ROAR-QUTRC/perseus-v2/README.md

# perseus-v2

The main codebase for perseus starting 2024

## Documentation

Full documentation is located [here](https://roar-qutrc.github.io/)

## CI/CD Status
