ROAR-QUTRC/perseus-v2/software/web_ui/README.md

# Rover UI

This repo contains the UI for controlling/viewing outputs from sensors on the rover.

### Running the UI

The Rover UI uses SvelteKit meaning that it does not need a server to be run and can be started by running this command in the root directory:

```shell
yarn # This installs dependencies
yarn host # This runs the server
```

This command with host the UI so with Vite so that it can be accessed by any device on the same network.  
**Note:** The hydration errors can be ignored

### Developing

To begin developing a widget run the command: `./create-widget.sh <file-name>`. The `file-name` argument is just the name of the file that contains the widget and **NOT** the widget name. This should generate a new file `/src/lib/widgets<file-name>.svelte` with this template contents:

```svelte
<script lang="ts" module>
	import type { WidgetSettingsType } from '$lib/scripts/state.svelte';

	export const name = 'New Widget';

	export const settings: WidgetSettingsType = $state<WidgetSettingsType>({
		groups: {}
	});
</script>

<script lang="ts">
	// Widget logic goes here
</script>

<p>New component</p>
```

- The first script tag with the `module` property is a server only module. This is used here as it is only run once when the component is first loaded and it also allows for exports that are used to expose some properties. You likely will not need to write your own code here.
  - **name -** This string is the unique name of the widget that will be displayed at the top of the widget and is used to ensure duplicates of widgets are not loaded.
  - **settings -** This is the object that structures the settings/state panel of each widget. Here is an example settings object and how to access the value of each setting:

    ```ts
    export const settings: WidgetSettingsType = $state<WidgetSettingsType>({
      groups: {
        general: {
          textSetting: {
            type: "text", // options are: text, number, switch, select, button
            value: "Some text", // This is a default value
          },
          hereIsAButton: {
            type: "button",
            action: () => {
              // action is executed on button press
              console.log("Button clicked");
              return "Success"; // string return value is printed in a toast
            },
          },
        },
        Advanced: {
          booleanSwitch: {
            type: "switch",
            description: "This is a switch", // fields with descriptions get a question mark next to their label
          },
          selectOptions: {
            type: "select",
            options: [
              { value: "1", label: "Option 1" },
              { value: "2", label: "Option 2" },
              { value: "3", label: "Option 3" },
            ],
          },
        },
      },
    });

    console.log(settings.groups.Advanced.booleanSwitch.value); // logs the state of the switch
    ```

- The second script tag is where your code should go as it is run client side when the component is rendered. The settings can be accessed here without an import and to listen for changes wrap the value you want to check in either a `$derived` or `$effect` rune. Furthermore, use `toast('message')` to send a toast from your widget.
- The remainder of the file is where mark down goes. Tailwind classes can be used on widgets for styling or a `<style></style>` block.

## TODO:

### Widgets

- Camera
- Battery
- Motor stats
- BMS (power bus states)
