ROAR-QUTRC/perseus-v2/software/arm-teleop-direct/README.md

# perseus-arm-teleop

Terminal based Arm Teleop for Perseus

By default this will connect two arms connected via serial ports on the one machine.

It will display torque readings and position.

Calibration values for leader and follower arms can be saved to a .yaml file.

Always make sure all servos are on the same baud rate. 1M baud is able to be handled.

# Build

```
mkdir build
```

```
cmake ..
make
```

# Use

You can run locally by running the application built from the build process.

Alternatively see below on how to use for teleoperation over a local network.

## To use over a network for teleoperation

We need to virtualise a remote serial port and present it as a local device. We can do this using the
Linux tool socat.

To install on Ubuntu

```
sudo apt install socat
```

#### First set up the Follower

This assumes serial port being used for the arm is /dev/ttyACM0.

```
socat TCP-LISTEN:7100,reuseaddr /dev/ttyACM0,b1000000,raw,echo=0
```

#### Second set up the Leader

This sets up a local file which is actually network connected to the remote serial port.
This assumes the remote machine has an IP Address of 192.168.1.15

```
socat PTY,link=/home/dingo/leader_follower,raw,echo=0 TCP:192.168.1.15:7100
```

Then run the application and the virtualised remote port should be detected automatically.

## TODO

- Handle rollover of values (joint #2 really needs this)
- Add PID to movements to reduce jerkiness
- Add ability to include 24 servos (second leader and second follower)
- Add additional diagnostic info

## DONE

- Add yaml config file loading
- Colour code torque values (mostly for gripper)
