ROAR-QUTRC/perseus-v2/docs/source/standards/README.md

# Standards

This section contains information about the standards to which hardware and software on-board the rover should be developed.
