ROAR-QUTRC/perseus-v2/docs/source/hardware-index.md

# Hardware

This sections contains information on the physical pieces of hardware within Perseus.
If you're looking for information on hardware _systems_, like networking, please see <project:/systems/hardware-index.md>.

## Board Name Abbreviations

```{glossary}
SBB
    <project:hardware/smol-brain-board.md>

RCB
    <project:hardware/rover-control-board.md>

CAN Daisy Chain Board
Daisy Chain Board
    <project:hardware/can-daisy-chain.md>

VESC
    The type of ESC used on Perseus. See more here: <project:hardware/vescs.md>
```

```{toctree}
:maxdepth: 1
:titlesonly:
:hidden:
:glob:
hardware/*
```
