ROAR-QUTRC/perseus-v2/docs/source/hardware/rover-control-board.md

# Rover Control Board

This PCB handles most of Perseus' power distribution and monitoring.
