ROAR-QUTRC/perseus-v2/docs/source/systems/hardware-index.md

# Hardware Systems

```{toctree}
hardware/assembly
hardware/i2c_imu
hardware/network
```
