ROAR-QUTRC/perseus-v2/docs/source/standards/hardware.md

# Hardware Design Guidelines

Power cables should be made with XT90 connectors only
