ROAR-QUTRC/perseus-v2/docs/source/standards-index.md

# Standards

This section contains information about the standards to which hardware and software on-board the rover should be developed.

```{toctree}
:maxdepth: 1
:titlesonly:
:hidden:
:glob:
standards/*
```
