ROAR-QUTRC/perseus-v2/software/ros_ws/src/perseus_simulation/models/perseus_arc_world/aruco_markers1/textures/aruco01.png

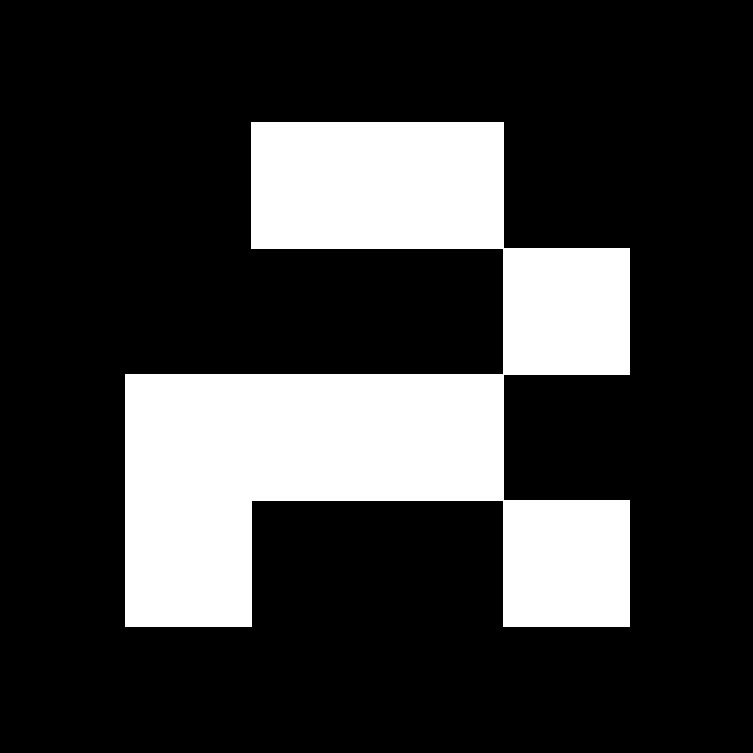
software/ros_ws/src/perseus_simulation/models/perseus_arc_world/aruco_markers1/textures/aruco01.png
