ROAR-QUTRC/perseus-v2/software/ros_ws/src/perseus_simulation/models/Moon_DEM/materials/textures/sand.jpg

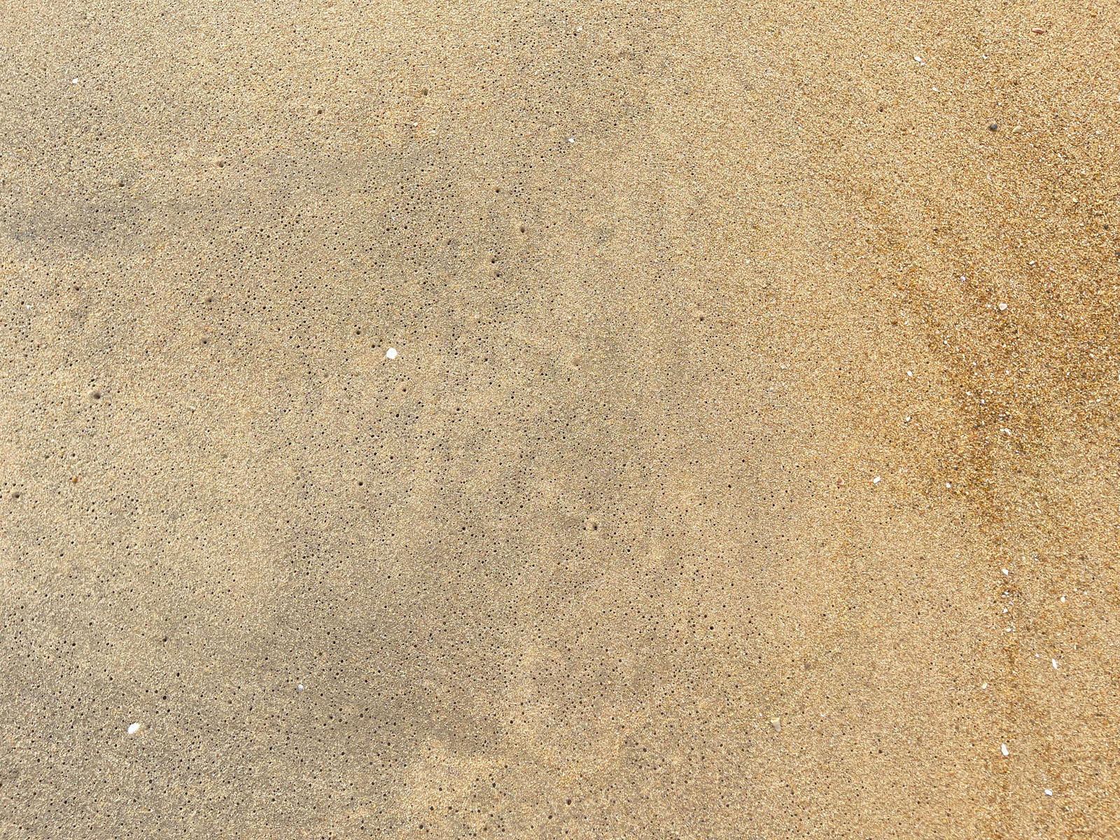
software/ros_ws/src/perseus_simulation/models/Moon_DEM/materials/textures/sand.jpg
