ROAR-QUTRC/perseus-v2/docs/source/tutorials-index.md

# Tutorials

This section contains a series of basic to intermediate tutorials that directly relate to systems in use on the rover. It is strongly recommended that all tutorials for a specific system are completed before you attempt to complete work on the rover.

Each tutorial should provide you with easy to follow instructions to start and finish a small example project. Any expected knowledge will be listed at the start of the tutorial and will related to existing tools that have their own documentation.

```{toctree}
:maxdepth: 1
:titlesonly:
:hidden:
:glob:
tutorials/*
```
