ROAR-QUTRC/perseus-v2/docs/source/home/perseus-lite-operation-index.md

# Perseus-Lite Operation

```{toctree}
:glob:
:hidden:
perseus-lite-operation/*
```
