ROAR-QUTRC/perseus-v2/docs/source/home/perseus-operation-index.md

# Perseus Operation

```{toctree}
:glob:
:hidden:
perseus-operation/*
```
