ROAR-QUTRC/perseus-v2/docs/source/maintenance/README.md

# Maintenance

This section contains the information you need to know to keep the rover software, documentation, and electronics updated and running long-term. If you don't read through these documents and understand what you're doing, you're liable to either break things, make it progressively harder to maintain, or both!
