ROAR-QUTRC/perseus-v2/docs/source/maintenance/software.md

# Software

## Versioning

As is mentioned in <project:/standards/software/general.md>, this project uses [Break Versioning](https://www.taoensso.com/break-versioning).
Whenever a package needs to be upversioned,

### CMake Projects

### Python Projects
