ROAR-QUTRC/perseus-v2/docs/source/maintenance/documentation.md

# Documentation

## Updating Python inputs

Run
