ROAR-QUTRC/perseus-v2/(threads)

Thread 2 (2024-10-10):

Generate real-time map from laser scans

DingoOz, 2024-10-10:
Ability to create a map from the sensors

DingoOz, 2025-01-10:
Links to PR:
#68

DingoOz, 2025-01-12:
Depends on #66

DingoOz, 2025-01-16:
Minimum viable product demosntrated:

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

DingoOz, 2025-01-16:
This uses slam toolbox with the lidar and imu data combined.

DingoOz, 2025-01-16:
Future test to see how it performs on Perseus with odom from ros2_control.

RandomSpaceship, 2025-01-16:
Going to reopen this until it's tested and proven reliable on the rover.

DingoOz, 2025-01-25:
Blocked until VESC upgrade complete

DingoOz, 2025-02-05:
Added documentation for basic operation - to support DFT/SAR.

RandomSpaceship, 2025-03-24:
MVP demonstrated with m2m2.

Closed 2025-03-24.

Thread 21 (2024-12-19):

Write git message format/etiquette guide

RandomSpaceship, 2024-12-19:
Having the Git messages in a (mostly) standard format makes it significantly easier to see what's changed at a glance.

RandomSpaceship, 2024-12-21:
Thoughts:

Format: `package` or `package(node)`, preferring, in order:
- `package(node)`: `sensors(m2m2_lidar)`
- `language(specification)`: `nix(flake)`
- `docs(section)`: `docs(architecture)`
- `chore`

Each commit should be a small logical block, which always leaves the code in a working state.

DingoOz, 2024-12-22:
+1 for calling this "gitiquette" or "commitiqutte" :)

DingoOz, 2024-12-22:
Point of style, should the comments after the colon start with a capital letter or lower case?

RandomSpaceship, 2024-12-23:
I don't really mind either way, but it probably should be uppercase if we're formalizing it.

RandomSpaceship, 2025-01-24:
Relevant projects:
https://www.conventionalcommits.org/en/v1.0.0/
https://conventional-branch.github.io/

I'm personally completely in favour of using Conventional Branch, since I just don't see any downsides. However, I'm a bit more hesitant about Conventional Commits, since it would require dropping the package information in the commit messages to maintain a reasonable message length. On the other hand, I'm no longer sure that including the package name in the commit has much value, since inspecting the commit itself makes it abundantly clear which package is affected, and in addition, some commits simply won't fit cleanly into that schema.

Thoughts?
@DingoOz @UltraFishy

DingoOz, 2025-01-24:
I like conventional branch. Although I feel like there is room between bugfix and feature for just "improvements"... but feature can usually cover that and it is better to align with a standard.

As for conventional commits. I am not aware of the short term benefit to the team for the extra work... whilst we are building out the functuonality for v1.0, we won't really have a need for "release notes" as we don't have releases yet and I think conventional commit message's strength is for release notes etc.

Just my thoughts.

RandomSpaceship, 2025-01-24:
Regarding your first point - agreed entirely. My view on conventional commits is that it makes it easy to determine the scope of a commit, but like I said, I have mixed feelings on it. Overall I'm personally more in favour of it than against though.

UltraFishy, 2025-01-24:
I'm all for the conventional branches! They will convey way more meaning into what's happening with the repo!

I'm not really sure about the conventional commits. I will say that we do need something along the lines of them but I don't know if this standard is the way to go.

RandomSpaceship, 2025-01-24:
Fair. What information do you think should be in the message/do you have any preliminary formatting ideas? The format I initially wrote up would be my preference if we decide against CC, but what are your thoughts on that?

UltraFishy, 2025-01-24:
Ok what about something like this:
```
<commit title>

<commit type>: <key change>
```
Then the commit types could be along the lines of:
- `feat`
- `fix`

This would be along the same lines as the conventional commits but alot more light weight. Just like Nigel is saying, we'll need to find a way to do it so that it's not too much of a hassle to implement.

I haven't seen your version, so you might have something on the same lines, but here is my thoughts.

RandomSpaceship, 2025-01-24:
I was referring to the second message I posted here, you can see that style in the commits around [here](https://github.com/ROAR-QUTRC/perseus-v2/commits/main/?after=1f064f8e4d19020738339c0d0f05768996412824+34).

At first glance I like your suggestion, but there are a couple of things I can see being potential problems:
- What about commits with no description? Should they be prefixed with a type?
- Most of the time the title will _be_ the change(s) made, rendering the description unnecessary
- It could get messy with notes in the extended commit message

If we decided to go with that format, I think it would make more sense to put the type in the commit title, in which case we're back to stripped-down conventional commits.

Thread 22 (2024-12-19):

Get main branch to a working state

RandomSpaceship, 2024-12-19:
Currently the working code is all located on `hi-can-dev` and isn't in a merge-able state. To get it ready to merge, it needs to have tests written (probably closing #10), all placeholders removed, and all template/example code replaced.

Closed 2024-12-21.

Thread 24 (2024-12-19):

Integrate the m2m2 lidar into sensors package

DingoOz, 2024-12-19:
Using the newly developed test code as a base, we need to integrate the m2m2 into the sensors package:  https://github.com/DingoOz/m2m2_test

Since the m2m2 uses port 1445 and nothing else does it might improve resiliency to have code that monitors which ip address has port 1445 open and selects the ip address that way. Or at least have a tool that can find the ip address based on the port so as to have a backup if static IP address fails.

RandomSpaceship, 2024-12-19:
I'm not a huge fan of running a port scanner full-time just to detect the lidar, and that's also not bulletproof (plus it's quite expensive) - and if we do have to use it, I'd rather it be streamlined and manual than automatic. A good option (if it supports it) would be to do lookup based on either its hostname or mDNS.

Closed 2024-12-26.

Thread 25 (2024-12-19):

Write standard for and implement `hi-can-common` for remote status monitoring and power control

RandomSpaceship, 2024-12-19:
All HiCAN compliant devices should implement status broadcasting and remote power control options. However, before implementation, we first need a standard (as well as to document HiCAN as it currently stands).

Thread 29 (2024-12-20):

Need to fix the hardcoded ip address and port for the m2m2 lidar

DingoOz, 2024-12-20:
//TODO: Need to set the ip address for m2m2_lidar via a param and not have it hardcoded to 192.168.1.243:1445 as per the code currently.

DingoOz, 2025-01-10:
Created branch "feat/m2m2-network-params" for this feature

DingoOz, 2025-01-11:
Pausing development of this branch whilst migrating to simple-networking first (#40

Closed 2025-02-05.

Thread 32 (2024-12-21):

Fix GH Actions required checks

RandomSpaceship, 2024-12-21:
Required checks is currently disabled due to this issue. If an Action is a required check for a PR to merge, but the PR never caused a change that would cause the action to run, the check will always be pending.

Closed 2024-12-22.

Thread 37 (2024-12-23):

Specialise `hi_can` exceptions to make specific error handling easier

RandomSpaceship, 2024-12-23:
Currently error handling can't be specialised in several cases, as a function may return the same exception class for multiple different failure modes.

Thread 38 (2024-12-24):

Feature Request: Optimise M2M2 Lidar node network data usage

DingoOz, 2024-12-24:
The M2M2 Lidar node should only use as much network bandwidth as needed and makes sense.

Once testsing confirms an ideal refresh rate for autonomy, the driver should have a feature to only send data at a rate that is needed for the desired refresh, rather than streaming continuously.

DingoOz, 2025-01-15:
Initial configuration generally uses ~30KB/s

Thread 40 (2024-12-26):

M2M2 sensor: Convert `sensors(m2m2)` to use `simple-networking` library

RandomSpaceship, 2024-12-26:
The implementation currently doesn't comply with software standards and will be hard to maintain, as the node in its current state mixes the responsibilities of network I/O and handling the LIDAR's comms protocol.

DingoOz, 2024-12-31:
Will update perseus_sesnors(m2m2_lidar) once advised that simple-networking is merged and stable.

RandomSpaceship, 2024-12-31:
That would have been #39, barring any major issues I don't think it'll be changing significantly from now. The implementation of a `Server` class _might_ change things (in particular the inheritance diagram) but none of the ideas I've got for that right now would change the `Client` usage that you'd need.

DingoOz, 2024-12-31:
Woohoo, thanks

DingoOz, 2025-01-11:
Code using new library has been tested successfully

DingoOz, 2025-01-11:
#72 PR submitted

DingoOz, 2025-01-12:
Changes pushed to address #72 feedback.

Closed 2025-01-12.

Thread 42 (2024-12-26):

Demonstrate Gazebo Harmonic simulation to support autonomy

DingoOz, 2024-12-26:
Autonomy will require copious amounts of testing, some of which might benefit from simulation.

Gazebo Fortress is the preferred simulation for ROS2 Jazzy, and it is worth investigating the feasibility of implementing it with Perseus.

IssacSim requires nVidia hardware and can be considered in parallel.

RandomSpaceship, 2024-12-26:
I love the idea of running simulations with Gazebo, but I'm not super enthused about Isaac Sim and the like. If it ties us to specific hardware, it just makes it so much harder to test, as well as making it a pain for everyone who might not have that hardware to develop software.

Definitely needs investigation though, maybe Isaac Sim is good enough to justify the trouble.

DingoOz, 2024-12-26:
Yes, I agree focus should be on Gazebo only at first.

Hopefully a Gazebo implementation done smartly doesn't block other simulations laters being integrated

DingoOz, 2025-01-06:
Current blocker: 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

RandomSpaceship, 2025-01-18:
Simulation successfully demonstrated on branch `gazebo-sim`. Not quite ready for merging yet due to a last couple of minor issues (rover doesn't want to turn), but almost there.

Closed 2025-01-18.

Thread 47 (2025-01-01):

Install VESCs onto rover

RandomSpaceship, 2025-01-01:
I've tested the software stack for driving the VESCs and it appears control them properly. I'm happy to call them ready for integration onto the chassis.

RandomSpaceship, 2025-01-28:
Done! #95 still needs to be resolved, but it's rolling, which was the main concern of this issue.

Closed 2025-01-28.

Thread 48 (2025-01-01):

Fix VESC status readback

RandomSpaceship, 2025-01-01:
Currently one of the VESC status packets isn't being parsed properly (there's a length mismatch). Given that all other status packets are 8 bytes long, it's likely to be Status 5. It appears that all _transmitted_ status packets are 8 bytes long, despite there only being 6 bytes of useful information in the status 5 packet, so the `raw_status_5_t` struct probably just needs an extra `uint16_t` of padding to make the length match.

RandomSpaceship, 2025-03-24:
Fixed.

Closed 2025-03-24.

Thread 49 (2025-01-01):

`perseus_hardware` controller activation should fail when network is down

RandomSpaceship, 2025-01-01:
If the CAN bus is available, but down, the controller will have fatal errors during configuration but still configure successfully.

Thread 57 (2025-01-06):

Fix intersphinx update workflow

RandomSpaceship, 2025-01-06:
Currently broken. There's no git user set up for the commit, and it won't be able to push to the main branch, so it should probably automatically set up a PR.

Thread 59 (2025-01-07):

Build second SO-100 arm

RandomSpaceship, 2025-01-07:

DingoOz, 2025-03-10:
Commenced an 18 hour PETG (black) print of all parts for another follower.

DingoOz, 2025-03-12:
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 Success of the first PETG arm - printed in a rush at .4mm layer.

DingoOz, 2025-03-13:
.2mm print failed. Will retry in .4mm

DingoOz, 2025-03-13:
.4mm print of plate started, due mid Saturday 15/3

Closed 2025-03-24.

Thread 60 (2025-01-07):

Write SO-100+ driver

RandomSpaceship, 2025-01-07:
We're using SO-100 arms for the Post-Landing task, but currently don't have a ROS-integrated driver to control them with.

DingoOz, 2025-01-25:
Need a get/set for the 6x ST3215 to facilitate teleop. This needs two nodes to achieve this.

DingoOz, 2025-02-02:
Will also need a calibration routine

RandomSpaceship, 2025-02-02:
What for? Determining the initial positions of all the servos?

DingoOz, 2025-02-28:
ROS integration is out of scope for Perseus v2, maybe v3

Closed 2025-02-28.

Thread 63 (2025-01-07):

Reprogram RCB with new baud rate

RandomSpaceship, 2025-01-07:
The Rover Control Board is currently talking on the CAN bus at 125K baud. After #47, it will need to be reprogrammed to use 500K baud.

RandomSpaceship, 2025-01-28:
Done, as of ~~tonight~~ yesterday!

Closed 2025-01-28.

Thread 66 (2025-01-09):

M2M2 sensor: Add IMU data

DingoOz, 2025-01-09:
The M2M2 mappers have an imu in them. This data needs to be extracted and published as a topic.

DingoOz, 2025-01-12:
Depends on #40

DingoOz, 2025-01-12:
Initial version demonstrated working. Branch is https://github.com/ROAR-QUTRC/perseus-v2/tree/feat/m2m2-imu

Closed 2025-01-16.

Thread 85 (2025-01-18):

Re-enable GH Actions linter once it supports the new OS's

RandomSpaceship, 2025-01-18:
The new ARM/aarch64 OS for GitHub Actions isn't yet supported in a release of `actionlint`, so it needs to be temporarily disabled. This issue is to serve as a reminder until it can be re-enabled, at which point this can be closed.

Closed 2025-03-24.

Thread 88 (2025-01-21):

Build longer Anderson -> XT60 cable

RandomSpaceship, 2025-01-21:
For the right side suspension arm

RandomSpaceship, 2025-01-28:
Suspension has enough flex to work for now, but should be resolved eventually.

DingoOz, 2025-01-29:
Looking at the video of the first run...I wasn't going to mention it :)

Closed 2025-03-24.

Thread 89 (2025-01-21):

Integrate bosch bmi088 imu

DingoOz, 2025-01-21:

DingoOz, 2025-01-21:
@Hortdog

HortDog, 2025-01-21:
BMI088 Docs:
https://www.bosch-sensortec.com/products/motion-sensors/imus/bmi088/

BMI088 c library:
https://github.com/boschsensortec/BMI08x_SensorAPI?tab=BSD-3-Clause-1-ov-file

RandomSpaceship, 2025-03-24:
Not planned for this iteration. May revisit later.

Closed 2025-03-24.

Thread 90 (2025-01-22):

Document ROS naming conventions

RandomSpaceship, 2025-01-22:
Currently there isn't really any documentation on how ROS nodes or the files within them should be named (eg launch files). Whilst it's easy to fix after the fact, it's annoying to have to and can be easily avoided.

Thread 91 (2025-01-22):

Alter the design of the so-100 elbow, print and test

DingoOz, 2025-01-22:

DingoOz, 2025-01-25:
Probably going to refer to this as SO-101 or SO-100+ arm

DingoOz, 2025-02-20:
Will do post testing of current design.

DingoOz, 2025-02-20:
depends on #133

RandomSpaceship, 2025-03-24:
Deemed not worth the effort.

Closed 2025-03-24.

Thread 93 (2025-01-25):

Integrate Livox mid-360 sensor to publish msgs

DingoOz, 2025-01-25:
DoD: When the livox mid-360 is sending properly formed ROS topics with pointcloud2 data.

DingoOz, 2025-01-26:
Here is the official driver, only supports up to Humble: https://github.com/Livox-SDK/Livox-SDK2

DingoOz, 2025-01-26:
Shouldn't be needed but just in case. The mid-360 protocol: https://livox-wiki-en.readthedocs.io/en/latest/tutorials/new_product/mid360/mid360.html

DingoOz, 2025-02-15:
Using version 1.2.4: https://github.com/Livox-SDK/livox_ros_driver2/releases/tag/1.2.4

DingoOz, 2025-02-15:
Base driver and basic test launch file added, not yet tested with hardware

RandomSpaceship, 2025-03-24:
Working as of yesterday.

Closed 2025-03-24.

Thread 95 (2025-01-28):

Fix left VESC configuration(s)

RandomSpaceship, 2025-01-28:
When loaded with the standard config, the motor simply shakes and refuses to rotate. When configured using the FOC Wizard, the motors run, but the motor parameters (particularly flux linkage) are way off the others, and particularly the motor configured with the wheel removed. My current thoughts that they probably need two of the three phase wires to the motor swapped if they're loaded with the default config, but either way, they need the following configured at a minimum:
- Battery current limits
- Motor min/max ERPM
- Min/max duty
- Motor min/max power (wouldn't accept 200W - does it perhaps need a firmware update?)
- And PID loop min ERPM

Thread 100 (2025-02-02):

Write driver node for RFID reader

DingoOz, 2025-02-02:
For the Post Landing task, Perseus needs to be able to read an RFID card to receive instructions.

RandomSpaceship, 2025-02-02:
Likely to be most easily accomplished by putting a microcontroller on the the arm and relaying the text over CAN.

DingoOz, 2025-02-13:
Not yet tested

DingoOz, 2025-02-14:
Functional testing taking place using lonelybinary esp32-s3, CANBUS not yet integrated.

RandomSpaceship, 2025-08-25:
No longer needed as of 2026 rules. For the 2025 competition, old Perseus V1-era RFID reader (outputting to serial) was used, with manual baud rate configuration using CLI tools, then echoing directly from the device.

Closed 2025-08-25.

Thread 103 (2025-02-02):

Detect coloured cubes and localise

DingoOz, 2025-02-02:
Need to have a ROS2 node that can be called to detect coloured cubes in a camera feed and to estimate the position of the cube.

This could be broken down into two nodes potentially.

Closed 2025-09-28.

Thread 109 (2025-02-05):

Manufacture arm mount sub-assembly

DingoOz, 2025-02-05:
Need to manufacture the 400mm frame to mount arms.

Includes the lineary actuator to raise and lower the arms by 250mm.

DingoOz, 2025-02-16:
Solid progress made, static assembly near complete, design for moving platform finalised

DingoOz, 2025-02-20:
redesign of front piece, now 2x 40mm for 8mm linear bearing mounting.

DingoOz, 2025-03-09:
Cyclone Alfred had significant impact

DingoOz, 2025-03-12:
10/16 primary holes drilled for the 8mm bearing mounting blocks

DingoOz, 2025-03-12:
Success on drilling 16 holes accurately:

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

DingoOz, 2025-03-12:
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

DingoOz, 2025-03-13:
Hardware manufactured.

Closed 2025-04-04.

Thread 113 (2025-02-05):

Document `nixgl` usage

RandomSpaceship, 2025-02-05:
It's currently in a README somewhere, but needs to be in the docs somewhere prominent since people keep running into the RViz issue (ie, run `nixgl rviz2` not `rviz2`).

Thread 127 (2025-02-16):

Arm: Demonstrate full teleoperation via a direct program

DingoOz, 2025-02-16:
Facilitate teleoperation of the SO-100 by direct code (non ROS).

Use this as a baseline for testing and a fall back for comp.

DingoOz, 2025-02-20:
Direct software currently is functional for direct teleportation.

Closed 2025-02-20.

Thread 129 (2025-02-17):

Add 2x 12V reset-able power supply for arms

DingoOz, 2025-02-17:
Add local Battery -> 12V converstion for the arms. Each arm should have about 4-5A available.

Thread 130 (2025-02-17):

Arm(feat): Smooth out motion

DingoOz, 2025-02-17:
Need to find the optimal approach with the ST3215 to smooth out the motion being replayed.

DingoOz, 2025-02-20:
Used servo acceleration maximum to adjust this.

Closed 2025-02-20.

Thread 139 (2025-02-28):

bugfix m2m2 imu topic

DingoOz, 2025-02-28:
Need to confirm that imu data is correct and working, in case it is not.

Closed 2025-04-12.

Thread 141 (2025-03-03):

Fix "No buffer space available" error

RandomSpaceship, 2025-03-03:
Under high bus load, CAN messages don't always get transmitted quickly. They can then fill up the transmit queue, causing an `ENOBUFS` error. To fix this, `txqueuelen` should be [adjusted](https://www.cyberciti.biz/faq/change-txqueuelen/) (the measured bus load is low enough that there should be no issues, it's just a case of bad timing unfortunately). This should be documented, and, if possible, added to a setup script (eg `machine-setup.sh`).

RandomSpaceship, 2025-03-03:
I believe the default queue length is currently 10 - adjusting it to 100 or even 1000 should fix the issue permanently.

Thread 149 (2025-03-10):

Create a single KeePass2 file that contains all secrets required to operate Perseus at competition

DingoOz, 2025-03-10:
Create a single KeePass2 file that encrypts all the secrets need to operate Perseus at competition.

https://keepass.info/download.html

KeePass2 is an open source password/secrets manager. It stores encrypted info in a text file which can be shared around.

Needs to have one person accountable for keeping up to date and accessible to the team at all times.

This would include:
* network SSID/Passwords
* logins for Orin's PI
* Codes to suitcases
* codes to any padlocks used

Could also include fixed IP addresses for devices on the network.

Thread 152 (2025-03-11):

Add Realsense D455 to the ROS2 stack

DingoOz, 2025-03-11:
The Intel Realsense should be introduced to the ROS2 Jazzy stack and to have a published pointcloud.

In all likelihood, will need to fight nix to get it all working.

RandomSpaceship, 2025-03-11:
Should be just adding `realsense2-camera` as a dependency in theory.

RandomSpaceship, 2025-03-24:
Basic point cloud data working perfectly on Pi 5 (Orin currently refuses to recognise the camera).

Closed 2025-03-24.

Thread 153 (2025-03-11):

Finish BMS Code

RandomSpaceship, 2025-03-11:
Currently working on the Battery Management System code, specifically the bq76942 driver. MVP is fully autonomous operation with no communications between modules or switching to higher-voltage cells.

RandomSpaceship, 2025-03-24:
MVP of independent operation verified.

Closed 2025-03-24.

Thread 178 (2025-04-04):

Mechanical part replacements (balance bar rod and locknuts)

BeHappyDog, 2025-04-04:
A few core mechanical parts need to be replaced, including all the locknuts (some are no longer locking), and the m6 stainless rod attaching the balance bar to the suspension arms.

Thread 179 (2025-04-04):

Reinforce suspension arms

BeHappyDog, 2025-04-04:
Gearbox mount plates on the suspension arms keep bending, they need to be reinforced. I have spoken to Duncan about this and he is inducted into defab and could do it for us there.

Thread 188 (2025-04-25):

CI/CD for PCBs

RandomSpaceship, 2025-04-25:
CI/CD for hardware designs may be valuable, and bears investigating. The biggest and most important of these would be a status check based on DRC and ERC tests. Another potentially valuable option would be automatically generated visual diffs of the PCB between commits. Finally, PCB manufacturing files (Gerbers, drill files, BOM, assembly data, etc...) can be automatically generated on merge into main, and uploaded as build artifacts. This would standardise the release process and eliminate the potential for human error.

This is intended to be the parent issue to a sub-issue for each of those tasks, which can be created as someone takes them on.

# Tasks
- [ ] Automated DRC and ERC checks
- [ ] Visual PCB diffs
- [ ] Visual schematic diffs
- [ ] Automated manufacturing job exports

# Resources

- [KiBot](https://github.com/INTI-CMNB/KiBot) for production file generation (potentially also automated diffs and DRC checks)
  - Blog post using it: https://sschueller.github.io/posts/ci-cd-with-kicad-and-gitlab/
- Visual diff generation: https://github.com/UltimateHackingKeyboard/uhk60v1-electronics/issues/24
- Preexisting scripted export workflow: https://github.com/scottbez1/smartknob/blob/master/.github/workflows/electronics.yml

Thread 202 (2025-06-21):

Implement Arena Boundary Detection System

DingoOz, 2025-06-21:
Develop robust arena boundary detection to prevent rover from leaving competition area and incurring disqualification.

- Arena boundary detection algorithm using provided schematic data
- Real-time boundary constraint integration with Nav2 costmaps
- immediate stop triggers for boundary approach
- Testing in marked boundary environments with 100% containment
- Documentation of boundary detection methodology

DoD:
Zero boundary violations in 10 consecutive test runs
Unit tests achieving >90% coverage
All Integration tests passing

Thread 203 (2025-06-21):

Develop Advanced Text Detection and OCR System

DingoOz, 2025-06-21:
Enhance text detection capabilities for reading placard content at various heights during landmark navigation.

Requirements:
- Integration with existing camera systems (C920, RealSense)
- Real-time processing capability on Jetson Orin Nano
- ROS2 service interface for text detection requests (implement as a service)
- Configurable OCR parameters
- OpenCV

DingoOz, 2025-08-30:
Traditionally (before LLMs) Google's Tesseract was widely used for OCR and I suspect that it might be more resource efficient then using a Gen AI model.   Since Tesseract with OpenCV has been a common ROS2 OCR pattern there ought to be a lot of documentation around for it too.

I suspect that it should be fairly easy and hence worth testing Tesseract performance in the first instance.

Since it is OpenCV we should also be able to leverage the Orin's CUDA for speed ups too.

Thread 204 (2025-06-21):

Optimise Sensor Fusion for Outdoor and Sandy Environments

DingoOz, 2025-06-21:
Improve extended Kalman Filter performance and sensor fusion for sandy outdoor competition environments.

- EKF parameter tuning for outdoor sandy terrain
- Real-time LiDAR point cloud processing optimisation (balance performance need vs bandwidth)
- IMU compensation algorithms (bias, drift)
- Localisation accuracy <0.2m in 20m radius testing
- Sensor fusion maintaining performance with 1 sensor failure (detection and graceful degradation)

Thread 208 (2025-06-22):

Implement Advanced Cube Detection System

DingoOz, 2025-06-22:
Develop computer vision system to detect and localise 4 coloured cubes (red, green, blue, white) with <300mm accuracy.

### Acceptance Criteria

- [ ] colour detection robust to lighting variations
- [ ] 3D point cloud analysis for precise cube localisation
- [ ] Kalman filtering for cube position estimation
- [ ] Validation using multiple sensor modalities
- [ ] Detection accuracy >95% for all cube colours
- [ ] Localisation accuracy <200mm in test environments

### Possible Technical considerations

- a ROS2 service to be called in BT
- HSV colour space filtering with adaptive thresholds
- RANSAC-based plane detection for cube faces
- Stereo depth camera triangulation

DingoOz, 2025-08-29:
Please review the Gtihub Contrib Standards in PR #246

Closed 2025-09-28.

Thread 262 (2025-09-02):

bug: ros2 control in nix develop shell

DingoOz, 2025-09-02:
There appears to be a bug in the nix develop .#simulation shell where ros2 control list_controllers will not run

DingoOz, 2025-09-02:
When following the simulation tutorial and trying to debug the ros2 controller state the command ros2 control list_controllers seems to fail.

This does seem to work though: ros2 service call
  /controller_manager/list_controllers
  controller_manager_msgs/srv/ListControllers

DingoOz, 2025-09-03:
From Gen AI analysis:

The ROS 2 control daemon issue could be caused by:

1. ROS_DOMAIN_ID mismatch: Your environment has ROS_DOMAIN_ID=51, but the Gazebo simulation (launched via nixGL) runs in a separate process that may not inherit this environment variable.
  This creates a communication barrier between your terminal and the simulation nodes.

 2. Process isolation with nixGL: The Gazebo simulation is launched through nixGL (nix run --impure github:nix-community/nixGL), which creates a wrapped process environment. This isolation can prevent the ROS 2 daemon from properly connecting to nodes within that environment.

3. Controller spawning sequence: The diff_drive_base_controller is spawned via the spawner node (controllers.launch.py:47-56), which loads but doesn't activate controllers by default. The
  spawner uses its own connection to the controller manager, bypassing the daemon.

4. Daemon timeout: The ROS 2 daemon tries to establish an XML-RPC connection but fails due to the process isolation and potential domain ID mismatch, resulting in the timeout error you see.

Possible solution: The service call approach (ros2 service call /controller_manager/switch_controller) works because it:
  - Creates a direct ROS 2 node connection instead of using the daemon
  - Inherits your current environment's ROS_DOMAIN_ID
  - Bypasses the nixGL process isolation by communicating through ROS 2 topics/services

  To fix this permanently, you could:
  1. Ensure ROS_DOMAIN_ID is passed to the nixGL process
  2. Use the --inactive flag when spawning controllers, then activate them manually
  3. Or continue using the direct service call approach which is more reliable in this setup
