ROAR-QUTRC/perseus-v2/docs/source/_static/CAN_Bus_Daisy_Chain.pdf

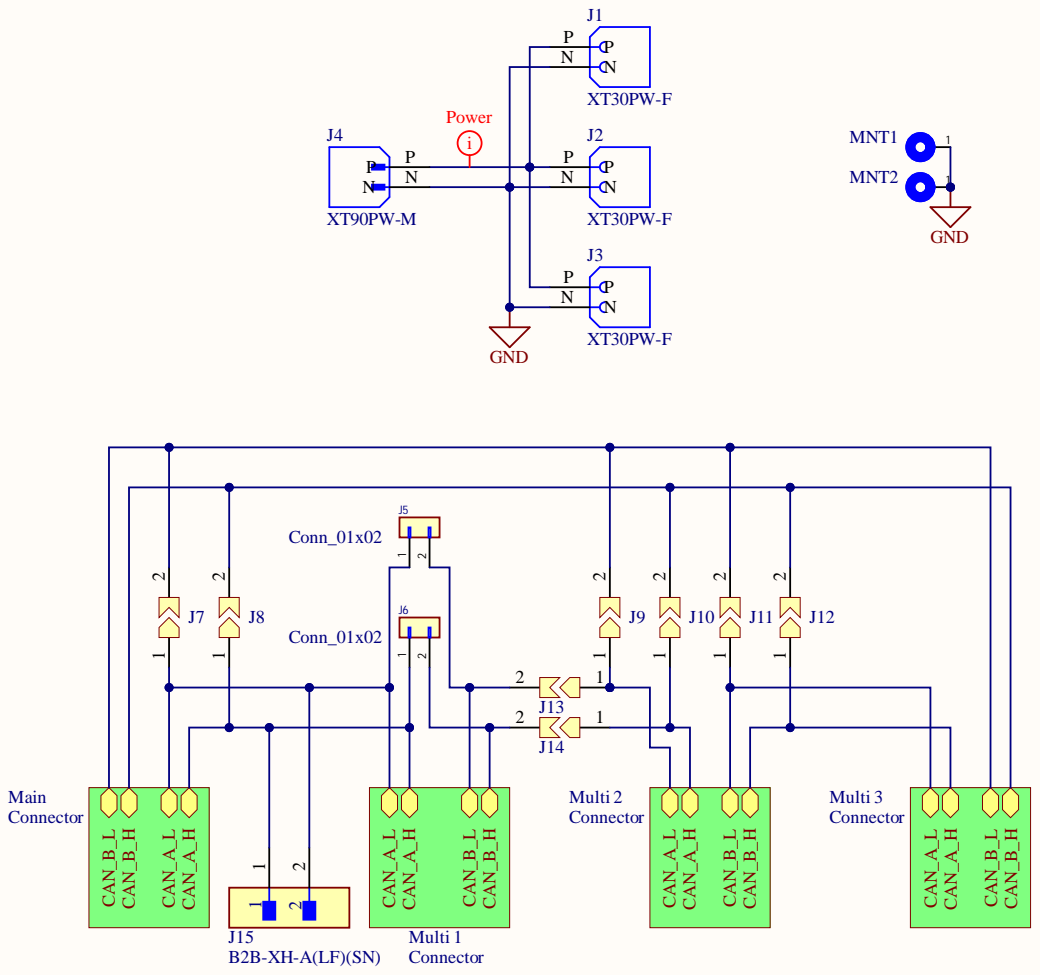
[picture p10: page 1]

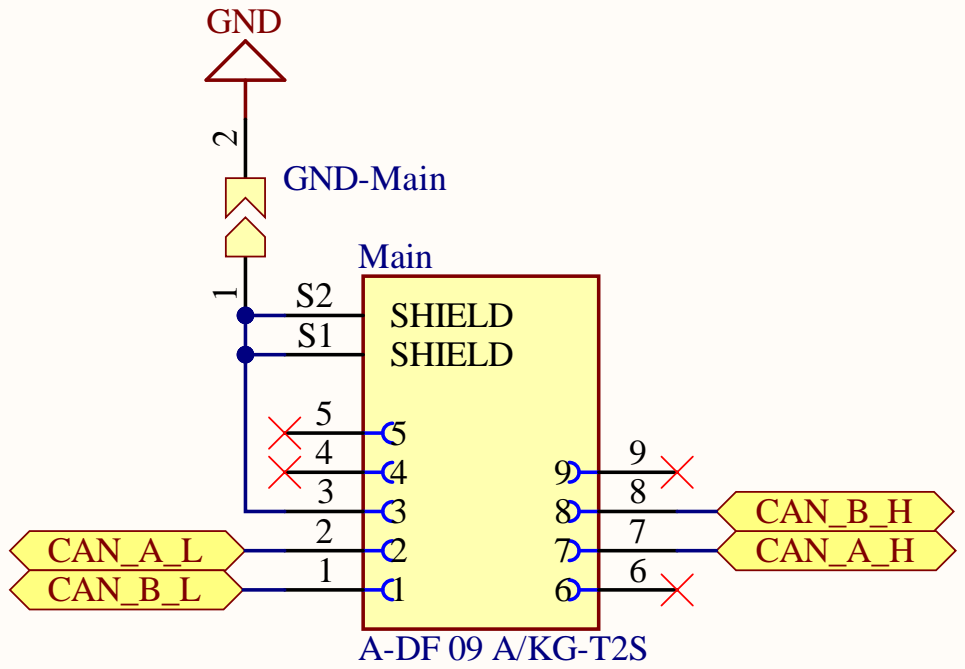
[picture p11: page 2]

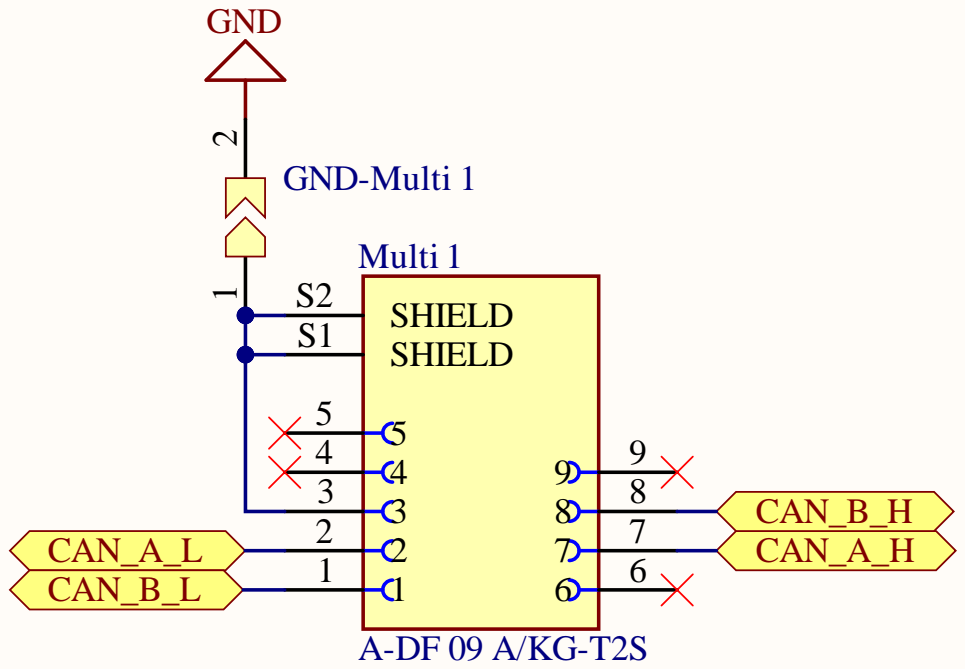
[picture p12: page 3]

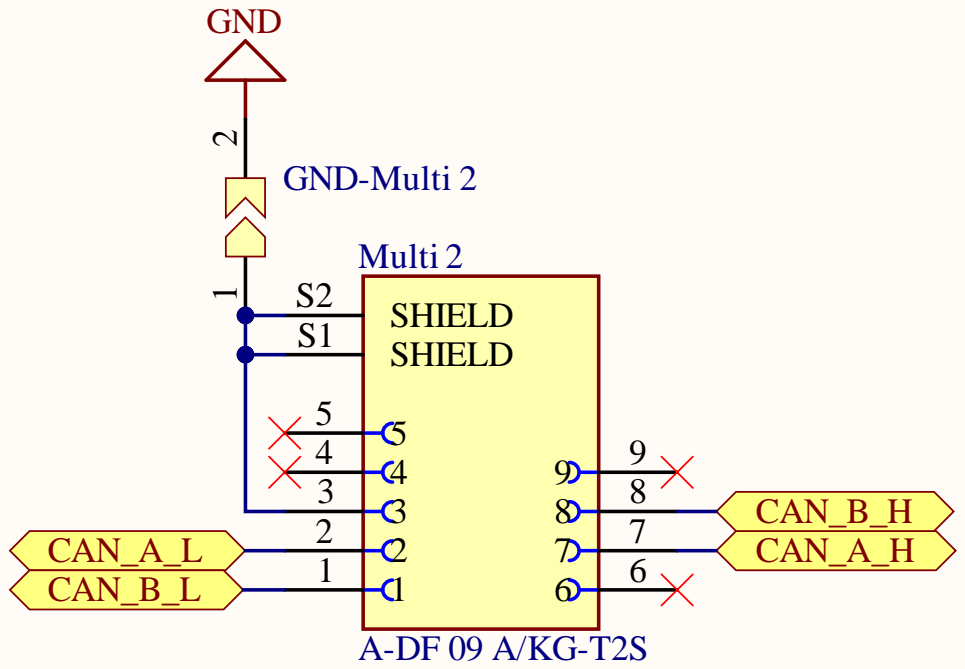
[picture p13: page 4]

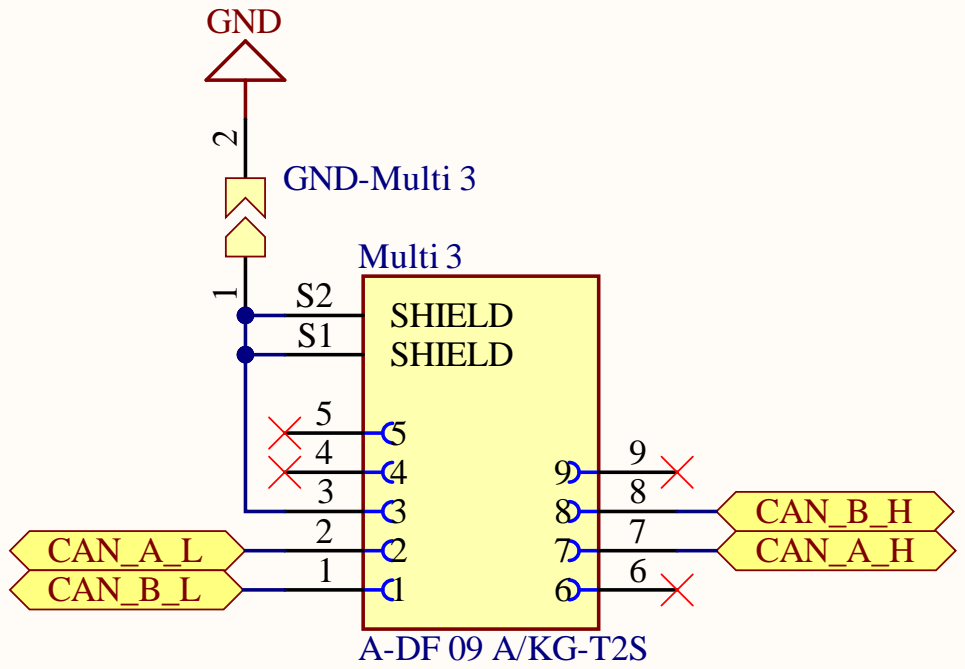
[picture p14: page 5]

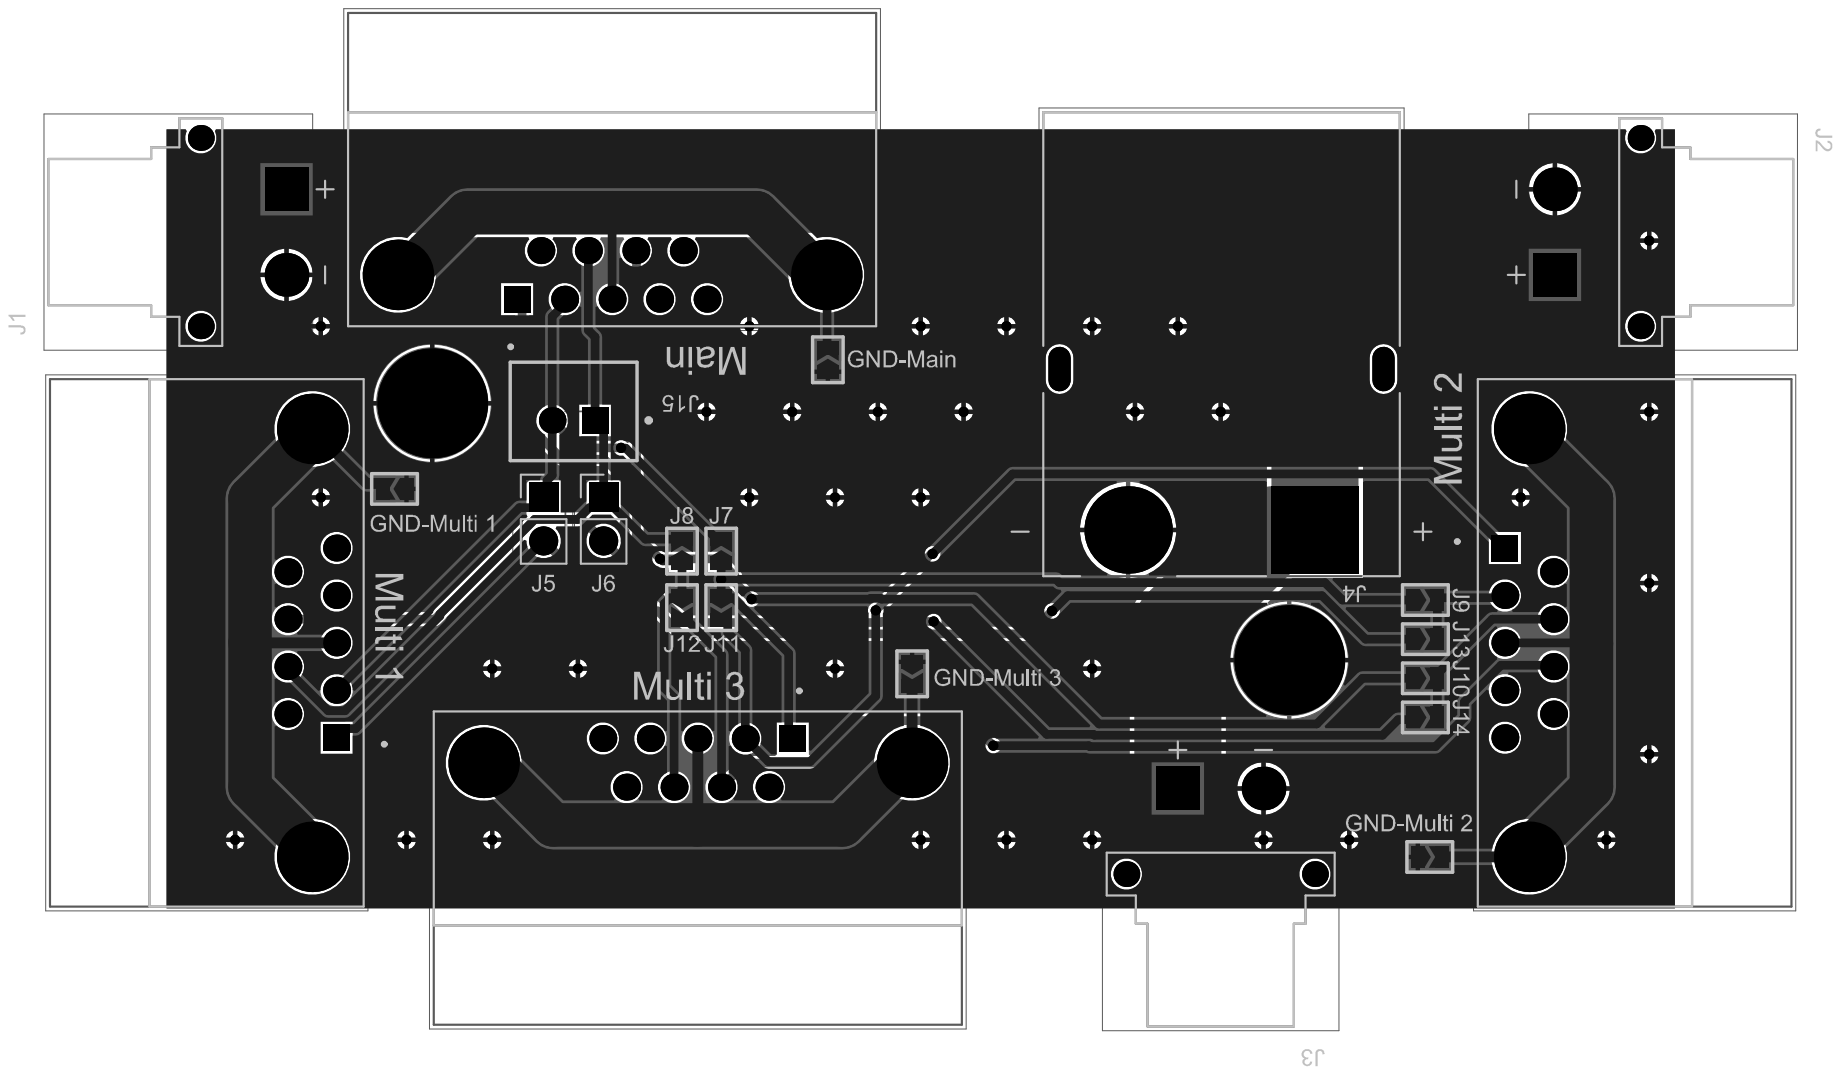
[picture p15: page 6]
