ROAR-QUTRC/perseus-v2/hardware/dc-motor-driver/dc-motor-driver.kicad_pcb

## KiCad design hardware/dc-motor-driver/dc-motor-driver.kicad_pcb (2025-04-29)

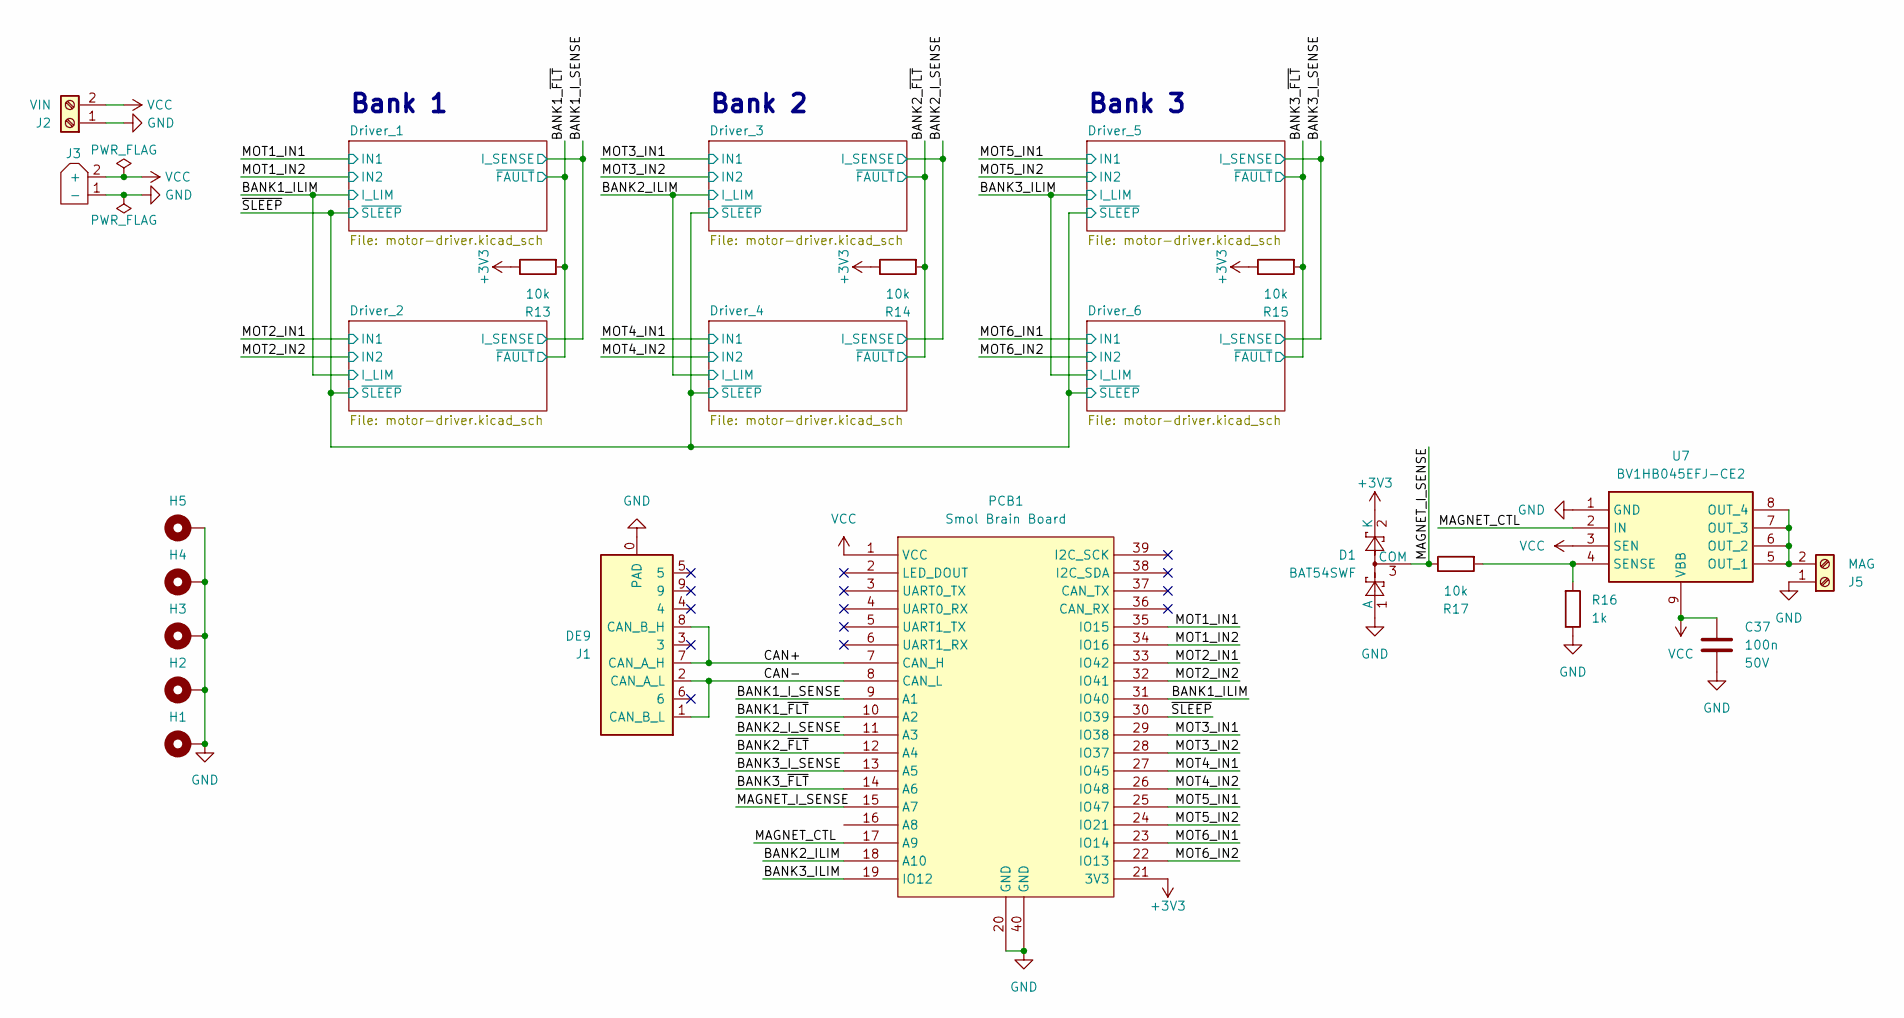
[picture p16: schematic dc-motor-driver.kicad_sch, DC Motor Driver]

Parts:
C37: 100n; C_0603_1608Metric
D1: BAT54SWF; SOT-323_SC-70
H1, H2, H3, H4, H5: MountingHole_Pad; MountingHole_3mm_Pad
J1: DE9; A-DF_09_A_KG-T2S
J2: VIN; TerminalBlock_4Ucon_1x02_P3.50mm_Horizontal
J3: AMASS_XT60PW-M_1x02_P7.20mm_Horizontal
J5: MAG; TerminalBlock_4Ucon_1x02_P3.50mm_Horizontal
PCB1: Smol Brain Board; Smol_Brain_Board
R13, R14, R15, R17: 10k; R_0603_1608Metric
R16: 1k; R_0603_1608Metric
U7: BV1HB045EFJ-CE2; HTSOP-8-1EP_3.9x4.9mm_P1.27mm_EP2.4x3.2mm_ThermalVias

Connections:
+3V3: D1.2 (K), PCB1.21 (3V3), R13.2, R14.2, R15.2; also elsewhere on the board
/BANK1_ILIM: PCB1.31 (IO40); also elsewhere on the board
/BANK1_I_SENSE: PCB1.9 (A1); also elsewhere on the board
/BANK1_~FLT: PCB1.10 (A2), R13.1; also elsewhere on the board
/BANK2_ILIM: PCB1.18 (A10); also elsewhere on the board
/BANK2_I_SENSE: PCB1.11 (A3); also elsewhere on the board
/BANK2_~FLT: PCB1.12 (A4), R14.1; also elsewhere on the board
/BANK3_ILIM: PCB1.19 (IO12); also elsewhere on the board
/BANK3_I_SENSE: PCB1.13 (A5); also elsewhere on the board
/BANK3_~FLT: PCB1.14 (A6), R15.1; also elsewhere on the board
/CAN+: J1.7 (CAN_A_H), J1.8 (CAN_B_H), PCB1.7 (CAN_H)
/CAN-: J1.1 (CAN_B_L), J1.2 (CAN_A_L), PCB1.8 (CAN_L)
/MAGNET_CTL: PCB1.17 (A9), U7.2 (IN)
/MAGNET_I_SENSE: D1.3 (COM), PCB1.15 (A7), R17.2
/MOT1_IN1: PCB1.35 (IO15); also elsewhere on the board
/MOT1_IN2: PCB1.34 (IO16); also elsewhere on the board
/MOT2_IN1: PCB1.33 (IO42); also elsewhere on the board
/MOT2_IN2: PCB1.32 (IO41); also elsewhere on the board
/MOT3_IN1: PCB1.29 (IO38); also elsewhere on the board
/MOT3_IN2: PCB1.28 (IO37); also elsewhere on the board
/MOT4_IN1: PCB1.27 (IO45); also elsewhere on the board
/MOT4_IN2: PCB1.26 (IO48); also elsewhere on the board
/MOT5_IN1: PCB1.25 (IO47); also elsewhere on the board
/MOT5_IN2: PCB1.24 (IO21); also elsewhere on the board
/MOT6_IN1: PCB1.23 (IO14); also elsewhere on the board
/MOT6_IN2: PCB1.22 (IO13); also elsewhere on the board
/~SLEEP: PCB1.30 (IO39); also elsewhere on the board
GND: C37.2, D1.1 (A), H1.1, H2.1, H3.1, H4.1, H5.1, J1.0 (PAD), J2.1, J3.1 (-), J5.1, PCB1.20 (GND), PCB1.40 (GND), R16.2, U7.1 (GND); also elsewhere on the board
unnamed: J5.2, U7.5 (OUT_1), U7.6 (OUT_2), U7.7 (OUT_3), U7.8 (OUT_4)
unnamed: R16.1, R17.1, U7.4 (SENSE)
VCC: C37.1, J2.2, J3.2 (+), PCB1.1 (VCC), U7.3 (SEN), U7.9 (VBB); also elsewhere on the board

Notes on the sheet:
Bank 2
Bank 3
Bank 1

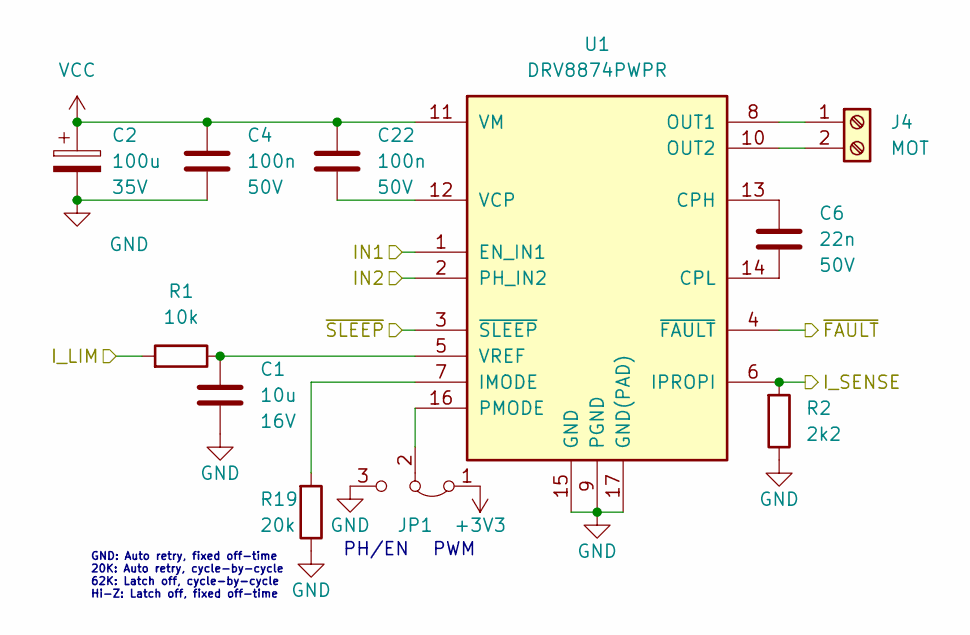
[picture p17: schematic motor-driver.kicad_sch, Motor Driver]

Parts:
C1: 10u; C_0805_2012Metric
C2: 100u; CP_Elec_6.3x7.7
C4, C22: 100n; C_0603_1608Metric
C6: 22n; C_0603_1608Metric
J4: MOT; TerminalBlock_4Ucon_1x02_P3.50mm_Horizontal
JP1: Jumper_3_Bridged12; SolderJumper-3_P1.3mm_Bridged12_RoundedPad1.0x1.5mm
R1: 10k; R_0603_1608Metric
R2: 2k2; R_0603_1608Metric
R19: 20k; R_0603_1608Metric
U1: DRV8874PWPR; HTSSOP-16-1EP_4.4x5mm_P0.65mm_EP3.4x5mm_Mask2.66x2.46mm_The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

Connections:
+3V3: JP1.1 (A); also elsewhere on the board
/BANK1_ILIM: R1.1; also elsewhere on the board
/BANK1_I_SENSE: R2.1, U1.6 (IPROPI); also elsewhere on the board
/BANK1_~FLT: U1.4 (~FAULT); also elsewhere on the board
/MOT1_IN1: U1.1 (EN_IN1); also elsewhere on the board
/MOT1_IN2: U1.2 (PH_IN2); also elsewhere on the board
/~SLEEP: U1.3 (~SLEEP); also elsewhere on the board
GND: C1.2, C2.2, C4.2, JP1.3 (B), R2.2, R19.2, U1.9 (PGND), U1.15 (GND), U1.17 (GND(PAD)); also elsewhere on the board
unnamed: J4.1, U1.8 (OUT1)
unnamed: J4.2, U1.10 (OUT2)
unnamed: JP1.2 (C), U1.16 (PMODE)
unnamed: C6.1, U1.13 (CPH)
unnamed: C6.2, U1.14 (CPL)
unnamed: R19.1, U1.7 (IMODE)
unnamed: C22.2, U1.12 (VCP)
unnamed: C1.1, R1.2, U1.5 (VREF)
VCC: C2.1, C4.1, C22.1, U1.11 (VM); also elsewhere on the board

Parts of its further copies:
C3, C7, C9, C13, C15: 10u; C_0805_2012Metric
C5, C10, C11, C16, C17, C23, C28, C29, C34, C35: 100n; C_0603_1608Metric
C8, C14, C20, C26, C32: 100u; CP_Elec_6.3x7.7
C12, C18, C24, C30, C36: 22n; C_0603_1608Metric
J6, J8, J10, J12, J14: MOT; TerminalBlock_4Ucon_1x02_P3.50mm_Horizontal
JP2, JP3, JP4, JP5, JP6: Jumper_3_Bridged12; SolderJumper-3_P1.3mm_Bridged12_RoundedPad1.0x1.5mm
R3, R5, R6, R8, R9: 2k2; R_0603_1608Metric
R4, R7, R10, R11, R12: 10k; R_0603_1608Metric
R20, R21, R22, R23, R24: 20k; R_0603_1608Metric
U2, U3, U4, U5, U6: DRV8874PWPR; HTSSOP-16-1EP_4.4x5mm_P0.65mm_EP3.4x5mm_Mask2.66x2.46mm_The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

Connections of its further copies:
+3V3: JP2.1 (A), JP3.1 (A), JP4.1 (A), JP5.1 (A), JP6.1 (A); also elsewhere on the board
/BANK1_ILIM: R4.1; also elsewhere on the board
/BANK1_I_SENSE: R3.1, U2.6 (IPROPI); also elsewhere on the board
/BANK1_~FLT: U2.4 (~FAULT); also elsewhere on the board
/BANK2_ILIM: R7.1, R10.1; also elsewhere on the board
/BANK2_I_SENSE: R5.1, R6.1, U3.6 (IPROPI), U4.6 (IPROPI); also elsewhere on the board
/BANK2_~FLT: U3.4 (~FAULT), U4.4 (~FAULT); also elsewhere on the board
/BANK3_ILIM: R11.1, R12.1; also elsewhere on the board
/BANK3_I_SENSE: R8.1, R9.1, U5.6 (IPROPI), U6.6 (IPROPI); also elsewhere on the board
/BANK3_~FLT: U5.4 (~FAULT), U6.4 (~FAULT); also elsewhere on the board
/MOT2_IN1: U2.1 (EN_IN1); also elsewhere on the board
/MOT2_IN2: U2.2 (PH_IN2); also elsewhere on the board
/MOT3_IN1: U3.1 (EN_IN1); also elsewhere on the board
/MOT3_IN2: U3.2 (PH_IN2); also elsewhere on the board
/MOT4_IN1: U4.1 (EN_IN1); also elsewhere on the board
/MOT4_IN2: U4.2 (PH_IN2); also elsewhere on the board
/MOT5_IN1: U5.1 (EN_IN1); also elsewhere on the board
/MOT5_IN2: U5.2 (PH_IN2); also elsewhere on the board
/MOT6_IN1: U6.1 (EN_IN1); also elsewhere on the board
/MOT6_IN2: U6.2 (PH_IN2); also elsewhere on the board
/~SLEEP: U2.3 (~SLEEP), U3.3 (~SLEEP), U4.3 (~SLEEP), U5.3 (~SLEEP), U6.3 (~SLEEP); also elsewhere on the board
GND: C3.2, C5.2, C7.2, C8.2, C9.2, C10.2, C11.2, C13.2, C14.2, C15.2, C16.2, C17.2, C20.2, C26.2, C32.2, JP2.3 (B), JP3.3 (B), JP4.3 (B), JP5.3 (B), JP6.3 (B), R3.2, R5.2, R6.2, R8.2, R9.2, R20.2, R21.2, R22.2, R23.2, R24.2, U2.9 (PGND), U2.15 (GND), U2.17 (GND(PAD)), U3.9 (PGND), U3.15 (GND), U3.17 (GND(PAD)), U4.9 (PGND), U4.15 (GND), U4.17 (GND(PAD)), U5.9 (PGND), U5.15 (GND), U5.17 (GND(PAD)), U6.9 (PGND), U6.15 (GND), U6.17 (GND(PAD)); also elsewhere on the board
unnamed: J6.1, U2.8 (OUT1)
unnamed: J6.2, U2.10 (OUT2)
unnamed: J8.1, U3.8 (OUT1)
unnamed: J8.2, U3.10 (OUT2)
unnamed: J10.1, U4.8 (OUT1)
unnamed: J10.2, U4.10 (OUT2)
unnamed: J12.1, U5.8 (OUT1)
unnamed: J12.2, U5.10 (OUT2)
unnamed: J14.1, U6.8 (OUT1)
unnamed: J14.2, U6.10 (OUT2)
unnamed: JP2.2 (C), U2.16 (PMODE)
unnamed: JP3.2 (C), U3.16 (PMODE)
unnamed: JP4.2 (C), U4.16 (PMODE)
unnamed: JP5.2 (C), U5.16 (PMODE)
unnamed: JP6.2 (C), U6.16 (PMODE)
unnamed: C12.1, U2.13 (CPH)
unnamed: C12.2, U2.14 (CPL)
unnamed: R20.1, U2.7 (IMODE)
unnamed: C23.2, U2.12 (VCP)
unnamed: C3.1, R4.2, U2.5 (VREF)
unnamed: C18.1, U3.13 (CPH)
unnamed: C18.2, U3.14 (CPL)
unnamed: R21.1, U3.7 (IMODE)
unnamed: C28.2, U3.12 (VCP)
unnamed: C7.1, R7.2, U3.5 (VREF)
unnamed: C24.1, U4.13 (CPH)
unnamed: C24.2, U4.14 (CPL)
unnamed: R22.1, U4.7 (IMODE)
unnamed: C29.2, U4.12 (VCP)
unnamed: C9.1, R10.2, U4.5 (VREF)
unnamed: C30.1, U5.13 (CPH)
unnamed: C30.2, U5.14 (CPL)
unnamed: R23.1, U5.7 (IMODE)
unnamed: C34.2, U5.12 (VCP)
unnamed: C13.1, R11.2, U5.5 (VREF)
unnamed: C36.1, U6.13 (CPH)
unnamed: C36.2, U6.14 (CPL)
unnamed: R24.1, U6.7 (IMODE)
unnamed: C35.2, U6.12 (VCP)
unnamed: C15.1, R12.2, U6.5 (VREF)
VCC: C5.1, C8.1, C10.1, C11.1, C14.1, C16.1, C17.1, C20.1, C23.1, C26.1, C28.1, C29.1, C32.1, C34.1, C35.1, U2.11 (VM), U3.11 (VM), U4.11 (VM), U5.11 (VM), U6.11 (VM); also elsewhere on the board

Notes on the sheet:
PWM
GND: Auto retry, fixed off-time 20K: Auto retry, cycle-by-cycle 62K: Latch off, cycle-by-cycle Hi-Z: Latch off, fixed off-time
PH/EN

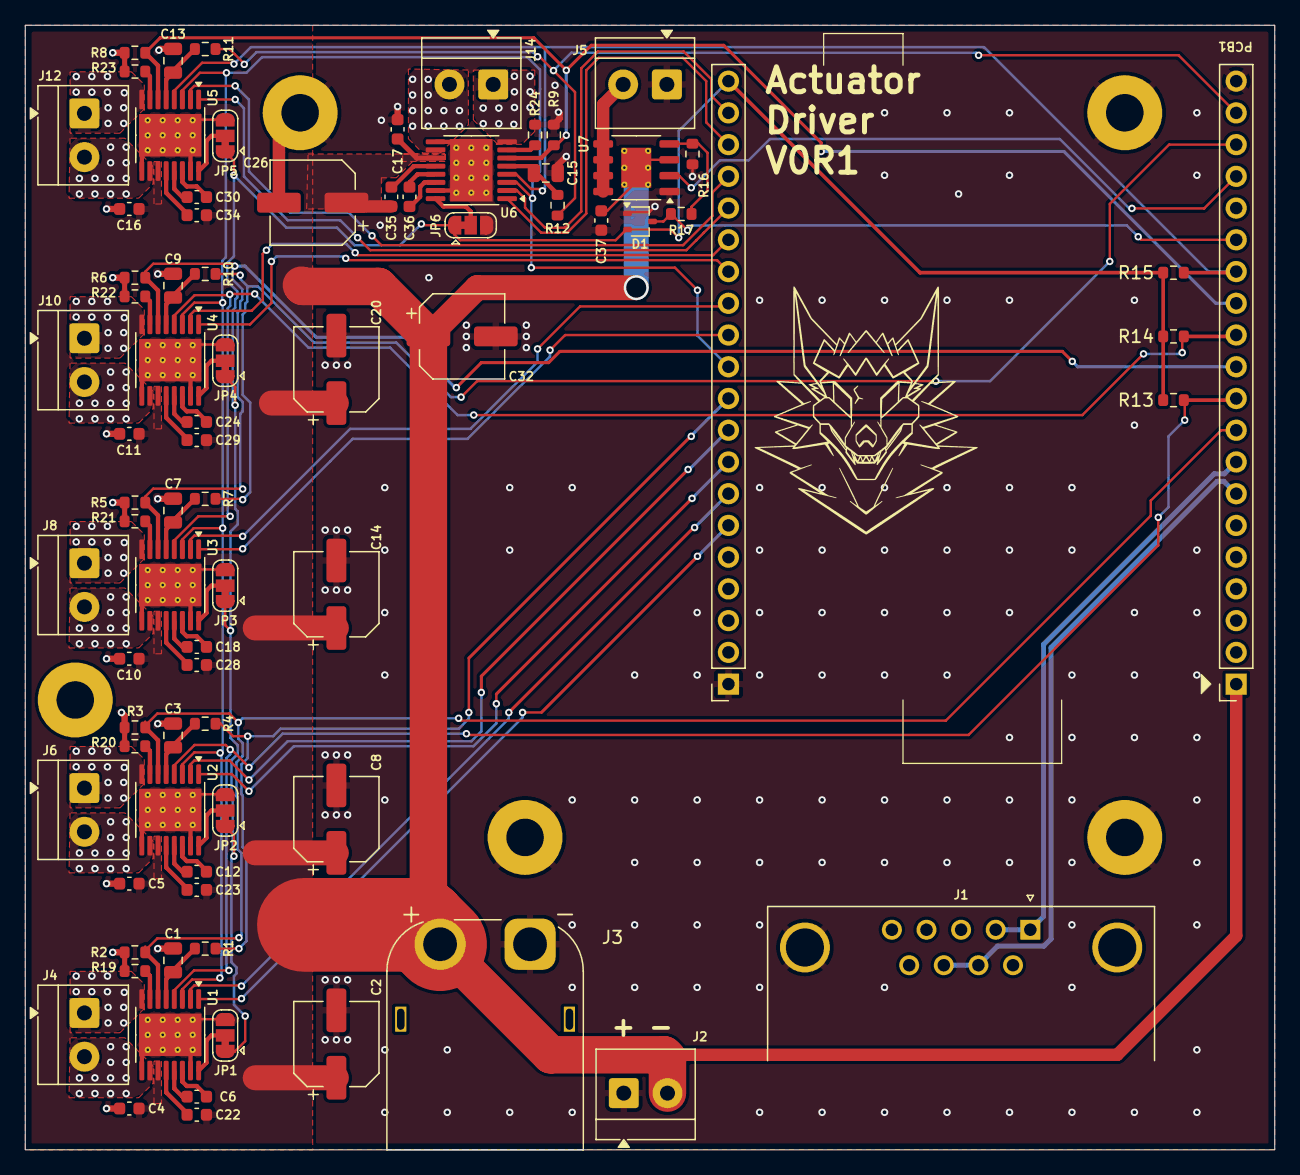
[picture p18: board dc-motor-driver.kicad_pcb from above]

Board: 2 copper layers, 100.0 x 90.0 mm, 84 parts (0 on the bottom side), 79 nets.
