ROAR-QUTRC/perseus-v2/firmware/battery-management-system/src/bq769x2.cpp

#include "bq769x2.hpp"

#include <Wire.h>
#include <crc.h>

#include <thread>
#include <type_demangle.hpp>

using namespace std::chrono;
using namespace std::chrono_literals;

bq76942::bq76942(uint8_t address)
    : _address(address)
{
    Wire.beginTransmission(_address);
    if (Wire.endTransmission())
    {
        throw std::runtime_error("Device not found");
    }
    // maximum data ever in CRC buffer is 4 bytes:
    // One for the address, one for the register, one for the re-started address, and one for the data byte
    _data_buf.reserve(4);
}

void bq76942::enter_deep_sleep()
{
    write_subcommand(cmd_only_subcommand::DEEPSLEEP);
    // see comment in shutdown() - must be written twice within 4s
    std::this_thread::sleep_for(100ms);
    write_subcommand(cmd_only_subcommand::DEEPSLEEP);
}

void bq76942::shutdown()
{
    write_subcommand(bq76942::cmd_only_subcommand::ALL_FETS_OFF);
    write_subcommand(cmd_only_subcommand::SHUTDOWN);
    // needs to be written twice within 4s to apply
    // NOTE: This doesn't apply in UNSEALED or FULLACCESS modes,
    // and the IC will shut down immediately in these modes.
    std::this_thread::sleep_for(100ms);
    write_subcommand(cmd_only_subcommand::SHUTDOWN);
}

void bq76942::enter_config_update_mode()
{
    write_subcommand(cmd_only_subcommand::SET_CFGUPDATE);
    // wait for IC to enter config update mode
    // TRM says 2ms approximate delay,
    // so may as well wait out the guaranteed time before checking
    std::this_thread::sleep_for(2.5ms);
    const auto start = steady_clock::now();
    // exact timeout doesn't matter, it shouldn't ever take long
    while ((steady_clock::now() - start) < 10ms)
    {
        if (get_battery_status().in_config_update_mode)
            return;
        std::this_thread::sleep_for(1ms);
    }
    throw std::runtime_error("Failed to enter config update mode - timed out!");
}

void bq76942::exit_config_update_mode()
{
    write_subcommand(cmd_only_subcommand::EXIT_CFGUPDATE);
    // wait for command to finish
    std::this_thread::sleep_for(2ms);
}

void bq76942::set_GPO(const gpo& pin, const bool state)
{
    switch (pin)
    {
    default:
        throw std::invalid_argument("Invalid GPO pin");
        break;
    case gpo::CFETOFF:
        write_subcommand(state ? cmd_only_subcommand::CFETOFF_HI : cmd_only_subcommand::CFETOFF_LO);
        break;
    case gpo::DFETOFF:
        write_subcommand(state ? cmd_only_subcommand::DFETOFF_HI : cmd_only_subcommand::DFETOFF_LO);
        break;
    case gpo::ALERT:
        write_subcommand(state ? cmd_only_subcommand::ALERT_HI : cmd_only_subcommand::ALERT_LO);
        break;
    case gpo::HDQ:
        write_subcommand(state ? cmd_only_subcommand::HDQ_HI : cmd_only_subcommand::HDQ_LO);
        break;
    case gpo::DCHG:
        write_subcommand(state ? cmd_only_subcommand::DCHG_HI : cmd_only_subcommand::DCHG_LO);
        break;
    case gpo::DDSG:
        write_subcommand(state ? cmd_only_subcommand::DDSG_HI : cmd_only_subcommand::DDSG_LO);
        break;
    };
}

void bq76942::force_permanent_fail()
{
    // to force permanent fail, word A and B must be written in order within 4s
    write_subcommand(cmd_only_subcommand::PF_FORCE_A);
    std::this_thread::sleep_for(100ms);
    write_subcommand(cmd_only_subcommand::PF_FORCE_B);
}

bq76942::firmware_version_t bq76942::get_firmware_version()
{
    firmware_version_t raw_version = read_subcommand<firmware_version_t>(subcommand::FW_VERSION);
    uint16_t device_number = (raw_version.device_number_bytes[0] << 8) | raw_version.device_number_bytes[1];
    // note: version number may be BCD too? not entirely clear in the TRM. Not a big deal though.
    uint16_t version_number = (raw_version.firmware_version_bytes[0] << 8) | raw_version.firmware_version_bytes[1];
    uint16_t firmware_version = (raw_version.bcd_high_of_high_byte * 1000) +
                                (raw_version.bcd_high_of_low_byte * 100) +
                                (raw_version.bcd_low_of_high_byte * 10) +
                                raw_version.bcd_low_of_low_byte;
    return {device_number, version_number, firmware_version};
}

bq76942::security_keys_t bq76942::get_security_keys()
{
    security_keys_t raw_keys = read_subcommand<security_keys_t>(subcommand::SECURITY_KEYS);
    // keys are stored in big-endian format so we need to re-construct them manually
    return security_keys_t{
        .unseal = {
            .step_1 = static_cast<uint16_t>((raw_keys.unseal.step_1_bytes[0] << 8) | raw_keys.unseal.step_1_bytes[1]),
            .step_2 = static_cast<uint16_t>((raw_keys.unseal.step_2_bytes[0] << 8) | raw_keys.unseal.step_2_bytes[1]),
        },
        .full_access = {
            .step_1 = static_cast<uint16_t>((raw_keys.full_access.step_1_bytes[0] << 8) | raw_keys.full_access.step_1_bytes[1]),
            .step_2 = static_cast<uint16_t>((raw_keys.full_access.step_2_bytes[0] << 8) | raw_keys.full_access.step_2_bytes[1]),
        },
    };
}

void bq76942::set_security_keys(const security_keys_t& keys)
{
    const security_keys_t big_endian_keys{
        .unseal = {
            .step_1_bytes = {static_cast<uint8_t>((keys.unseal.step_1 >> 8) & 0xFF), static_cast<uint8_t>(keys.unseal.step_1 & 0xFF)},
            .step_2_bytes = {static_cast<uint8_t>((keys.unseal.step_2 >> 8) & 0xFF), static_cast<uint8_t>(keys.unseal.step_2 & 0xFF)},
        },
        .full_access = {
            .step_1_bytes = {static_cast<uint8_t>((keys.full_access.step_1 >> 8) & 0xFF), static_cast<uint8_t>(keys.full_access.step_1 & 0xFF)},
            .step_2_bytes = {static_cast<uint8_t>((keys.full_access.step_2 >> 8) & 0xFF), static_cast<uint8_t>(keys.full_access.step_2 & 0xFF)},
        },
    };
    write_subcommand(subcommand::SECURITY_KEYS, big_endian_keys);
}

bq76942::manufacturer_data_t bq76942::get_manufacturer_data()
{
    const auto data_vec = read_subcommand(subcommand::MANU_DATA);
    manufacturer_data_t data_arr;
    if (data_vec.size() != data_arr.size())
        throw std::runtime_error("Manufacturer data size mismatch");
    std::copy(data_vec.begin(), data_vec.end(), data_arr.begin());
    return data_arr;
}

void bq76942::set_manufacturer_data(const manufacturer_data_t& data_arr)
{
    std::vector<uint8_t> data_vec(data_arr.size(), 0);
    std::copy(data_arr.begin(), data_arr.end(), data_vec.begin());
    write_subcommand(subcommand::MANU_DATA, data_vec);
}

bq76942::da_status_5_t bq76942::get_DA_status_5()
{
    const raw_da_status_5_t raw_status = get_raw_DA_status_5();
    const da_configuration_t da_config = settings.configuration.get_DA_configuration();
    return da_status_5_t{
        .vreg_18_adc_counts = raw_status.vreg_18_adc_counts,
        .vss_adc_counts = raw_status.vss_adc_counts,
        .max_cell_voltage = raw_status.max_cell_voltage,
        .min_cell_voltage = raw_status.min_cell_voltage,
        .battery_voltage_sum = raw_status.battery_voltage_sum * get_user_volts_multiplier(da_config),
        .cell_temperature = raw_temp_to_celsius(raw_status.cell_temperature),
        .fet_temperature = raw_temp_to_celsius(raw_status.fet_temperature),
        .max_cell_temperature = raw_temp_to_celsius(raw_status.max_cell_temperature),
        .min_cell_temperature = raw_temp_to_celsius(raw_status.min_cell_temperature),
        .avg_cell_temperature = raw_temp_to_celsius(raw_status.avg_cell_temperature),
        .cc_3_current = static_cast<float>(raw_status.cc_3_current) * get_user_amps_multiplier(da_config),
        .cc_1_current = static_cast<float>(raw_status.cc_1_current) * get_user_amps_multiplier(da_config),
        .cc_2_counts = raw_status.cc_2_counts,
        .cc_3_counts = raw_status.cc_3_counts,
    };
}

bq76942::da_status_6_t bq76942::get_DA_status_6()
{
    const raw_da_status_6_t raw_status = get_raw_DA_status_6();
    const da_configuration_t da_config = settings.configuration.get_DA_configuration();

    const float acc_charge_integer = static_cast<float>(raw_status.accumulated_charge);
    float acc_charge_fractional = static_cast<float>(raw_status.accumulated_charge_fraction) / (1ULL << 32);
    acc_charge_fractional -= 0.5;  // starts initialised to +0.5 user_ah, zero that out

    return da_status_6_t{
        .accumulated_charge = (acc_charge_integer + acc_charge_fractional) * get_user_amps_multiplier(da_config),
        .accumulated_charge_time = std::chrono::seconds(raw_status.accumulated_charge_time),
        .cfetoff_counts = raw_status.cfetoff_counts,
        .dfetoff_counts = raw_status.dfetoff_counts,
        .alert_counts = raw_status.alert_counts,
        .ts1_counts = raw_status.ts1_counts,
        .ts2_counts = raw_status.ts2_counts,
    };
}

std::vector<uint8_t> bq76942::read_direct(const uint8_t register_addr, const size_t bytes)
{
    for (int i = 0; i <= MAX_RETRIES; i++)
    {
        try
        {
            return _read_direct(register_addr, bytes);
        }
        catch (...)
        {
            if (i >= MAX_RETRIES)
                throw;
            std::this_thread::sleep_for(1ms);
        }
    }
    // control can never reach here (the loop will either return or throw),
    // but let's make the compiler happy
    return {};
}

void bq76942::write_direct(const uint8_t register_addr, const std::vector<uint8_t>& data)
{
    for (int i = 0; i <= MAX_RETRIES; i++)
    {
        try
        {
            _write_direct(register_addr, data);
            return;
        }
        catch (...)
        {
            if (i >= MAX_RETRIES)
                throw;
            // TODO: Change this to be not a magic constant
            std::this_thread::sleep_for(10ms);
        }
    }
}

std::vector<uint8_t> bq76942::read_subcommand(const uint16_t register_addr)
{
    for (int i = 0; i <= MAX_RETRIES; i++)
    {
        try
        {
            return _read_subcommand(register_addr);
        }
        catch (...)
        {
            if (i >= MAX_RETRIES)
                throw;
            std::this_thread::sleep_for(10ms);
        }
    }
    // control can never reach here (the loop will either return or throw),
    // but let's make the compiler happy
    return {};
}
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
