ROAR-QUTRC/perseus-v2/(commit log)

2024-10-15 fix hi-can-lib build failure
    [hi_can_packet.cpp, main.cpp]
2024-11-08 Make top-level directory names lowercase
    Closes: Can we make the first letter of the "Software" folder a lower case? #3
2024-11-09 Colcon warning silencing + defaults, nix tooling clean up
    - Unnecessary colcon warnings are now filtered out (wrapped with stderr passed through grep)
    - Colcon and extensions moved to separate overlay
    - Create colcon defaults file and set environment variable to use it by default
2024-11-17 Add Doxygen configuration
    [Doxyfile-prj.cfg, Doxyfile.cfg]
2024-11-18 Move doxygen config overrides into Sphinx conf.py
    [Doxyfile-prj.cfg, Doxyfile.cfg]
2024-11-18 Configure intersphinx and myst-parser, add and switch to sphinx-immaterial
    - Add python and ros intersphinx mappings
    - Enable select myst extensions
    - Configure sphinx-immaterial
    - Configure sphinx-rtd-theme
2024-11-21 Add has-dark-opt class which switches in dark mode URL for images
2024-11-21 remove unnecessary `+ "/"` from derivation filtering
2024-11-29 Remove software/machines directory - currently unused
2024-11-29 docs(nix): Switch docs build env to use stable packages
2024-11-29 remove FilteredCanInterface swap function
    FilteredCanInterfaces cannot be allowed to swap directly, as attempting to swap derived classes cast to FilteredCanInterfaces will cause very bad things to happen (classes left in an invalid state due to not all members being swapped)
2024-11-29 can-interface rename to net-can-server + fix dependencies
    [main.cpp]
2024-11-29 fix hi_can::packet initialisation from buffer
    [hi_can_packet.cpp, hi_can_packet.hpp]
2024-11-29 Fix const-ness of CanInterface::transmit, add optional nonblocking flag
    [hi_can.cpp, hi_can.hpp]
2024-11-29 fix data set methods on packet
    [hi_can_packet.cpp, hi_can_packet.hpp]
2024-11-29 fix net-can-server release build
    [main.cpp]
2024-12-03 hi-can: Set up GTest framework
2024-12-07 ros: Rename `perseus_bringup` to `perseus` to bring in line with de facto standard
2024-12-10 hi_can: Split PacketManager transmit+receive, fix not calling receive internally
    [hi_can.cpp, hi_can.hpp]
2024-12-10 ros_ws: Add perseus_description package
    [chassis.urdf.xacro, motor_wheel.urdf.xacro, perseus.materials.xacro, perseus.ros2_control.xacro, perseus.urdf.xacro, rocker.urdf.xacro, wheel.urdf.xacro]
2024-12-10 ros_ws: Setup perseus package ros2 bringup
    [perseus.urdf.xacro, perseus_controllers.yaml]
2024-12-21 perseus_description: Inherit xacro parameters
    This reduces things like `prefix="${prefix}"` quite a lot
    [chassis.urdf.xacro, motor_wheel.urdf.xacro, perseus.urdf.xacro, rocker.urdf.xacro, wheel.urdf.xacro]
2024-12-21 perseus_description: Add CAN bus and h/w config arguments
    Exposing these as xacro arguments allows selecting multiple launch configurations without modifying raw `*.xacro` files.
    [perseus.ros2_control.xacro, perseus.urdf.xacro]
2024-12-21 hi-can: Implement `ParameterGroup`s
    - Packet now uses `std::vector` instead of `std::array`
    - Move `PacketManager` into packet source files instead of root `hi_can.*pp`
    - Fix timeout detection for `PacketManager`
    [hi_can.cpp, hi_can.hpp, hi_can_packet.cpp, hi_can_packet.hpp, hi_can_parameter.hpp]
2024-12-21 hi-can-raw: Temporarily disable filtering
2024-12-21 hi-can: Addressing utility functions
    - Add functions to `filter_t` to get its masked/unmasked address
    - Allows constructing a `standard_address_t` from another one whilst overriding the group and parameter IDs
2024-12-21 hi-can: Add legacy device addressing
    This allows constructing message IDs for the RCB and MCB's.
2024-12-21 hi-can: Untested VESC support (addrs + params)
2024-12-21 hi-can: Fix type name typo
    [hi_can_parameter.hpp]
2024-12-21 perseus: Increase speed+accel limits
    [perseus_controllers.yaml]
2024-12-21 perseus_description: Add current+temperature state interfaces
    Also macro-fied the definitions to avoid copy-pasting everything
    [perseus.ros2_control.xacro]
2024-12-21 perseus: Map current->effort for topic `/joint_states`
    [perseus_controllers.yaml]
2024-12-21 hi-can(-raw): Fix RTR packet support
    Specifically, allow zero length data packets.
    [hi_can_packet.cpp, hi_can_packet.hpp]
2024-12-21 hi-can: Fix status 6 ID, add numbering to status 1
    Inspecting the VESC source code shows that the STATUS_6 ID is actually 58, not 28 like the docs say.
    [hi_can_address.hpp, hi_can_parameter.cpp, hi_can_parameter.hpp]
2024-12-21 nix(flake): General cleanup
    - Remove old (outdated) sim packages
    - Add `joy` package to default shell packages
    - Switch to `runCommandNoCC` for "dummy" packages used only for passthru
    - Move `tools.scripts` -> `scripts`
2024-12-21 perseus: Add launch file
    Also set `lock_memory` to false for the ROS2 control `controller_manager` since we're not on an RT system and it will always fail
    [perseus_controllers.yaml]
2024-12-21 perseus_hardware: Initial MCB+VESC implementation done
2024-12-22 ci-cd(filters): Run all jobs on filters update
2024-12-26 persues_sensors(m2m2)lidar): Added a README file for this node.
    Readme file is useful for communicating how this node is generally
    used; how it might be used independently of persues bringup and
    that there are features which are still be worked on.
2024-12-26 perseus_sensors(m2m2_lidar): added copy constructor
    added a copy constructor (part of the Rule of Three)
    perseus_sensors(m2m2_lidar): Added copy assignment operator
    Add the copy assignment operator for the Rule of Three
    perseus_sensors(m2m2_lidar): Added move and assignement constructor
    Rule of Five implementation.
    perseus_sensors(m2m2_lidar): Clamping protection _createConfigCommand
    perseus_sensors(m2m2_lidar): set copy operators to delete
    perseus_sensors(m2m2_lidar): Used copy-and-swap for Rule of 3
    perseus_sensors(m2m2_lidar): swap defined inline in header
2024-12-26 input_devices(xbox_controller): High-speed deadman's switch added
2025-01-11 autonomy: bugfix to align autonomy launch with current project
    The code predated the current software standards and templates.
    Brought up to date.
2025-01-15 Clean up and added camera prototype widget
2025-01-16 Camera doesn't cache each frame now
2025-01-18 documentation: Added a warning to stage ROS2 packages pre nix build
2025-01-20 feat: Clean up description URDF
    [chassis.urdf.xacro, perseus.urdf.xacro, rocker.urdf.xacro, wheel.urdf.xacro]
2025-01-20 feat: Implement running simulation using `gz`
    - Created `perseus_simulation` package
    - Refactored `perseus` package to remove `bringup` folder
    - Modularised launch files for individual logical components
    - Add `nixGL` and `nix-gl-host` to flake inputs for running RViz and Gazebo
    - Clean up `ros2_control` description
    - Occasional Nix code/comment cleanup
    - Properly split simulation/non-sim workspaces so Gazebo is no longer included by default
    [perseus.ros2_control.xacro, perseus.urdf.xacro, perseus_controllers.yaml, perseus_world.sdf, ros2_control_sim.yaml]
2025-01-24 persues_simulation: addded readme and tuned wheel attributes
    - Lowered friction to allow for turning
    - Added a very basic readme with basic commands
    [wheel.urdf.xacro]
2025-01-24 perseus_simulation: added a basic lunar landscape
    [perseus_world.sdf]
2025-01-31 fix: Correctly define simulated wheel friction
    [wheel.urdf.xacro]
2025-01-31 feat: Add LIDAR to simulation
    Based on Livox Mid-360, but with a purely horizontal scan.
    [empty.sdf, perseus.urdf.xacro, perseus_world.sdf, sensors.urdf.xacro]
2025-02-02 Fixed bug where buttons became text fields
2025-02-02 perseus_sensors(m2m2_lidar): extract imu data and publish /imu
2025-02-02 autonomy: started with the slam_toolbox launch file for handheld
    Fixed up laser_scan_matcher and added odom to slamtoolbox
    [ekf_config.yaml]
2025-02-02 autonomy: Added tf2_tools to the nix environment
    Fixed launch to use correct yaml and added base_link tf
    Additional TF link added in launch
    [mapper_params_online_async.yaml, mapper_params_online_sync.yaml]
2025-02-02 autonomy: update the description with base_footprint
    [perseus.urdf.xacro]
2025-02-02 perseus_sensors: fixed imu frame id
2025-02-02 perseus_sensors: used C++20 string type for imu & removed while loops
    chore: Format and lint
    perseus_sensors: remove while loop in _interpolatePoints
2025-02-02 autonomy: reverted tf tree to base_link from base_footprint
    [perseus.urdf.xacro]
2025-02-02 perseus_description: added the m2m2 lidar to the xacro
    [sensors.urdf.xacro]
2025-02-03 feat: Add `perseus_payloads` package
    contains nodes:
    - `arm_driver` for SO-100 robot arm
    - `bucket_driver` for Excavation & Construction bucket
2025-02-03 feat: Add legacy e&c bucket CAN messages
    Includes refactor to add `SimpleSerializable` class to reduce serialization boilerplate
2025-02-03 feat: Add bucket driver node
    Takes `Actuator` messages and converts them to CAN packets, with fail-safe
    [bucket_driver.cpp]
2025-02-03 fix: Delete move assignment
    Fixes assignments from rvalues matching both the copy and move assignment operators
    [hi_can_address.hpp]
2025-02-03 feat: Add `bucket_controller` node
2025-02-03 fix: Remove unneeded includes
    [bucket_driver.cpp]
2025-02-03 Added delay and correct command to illuminate strip
    [main.cpp]
2025-02-04 Cameras work with one client open
2025-02-05 perseus_simulation: changed the controller launch sequence
    - possible race condition on launch causing the timeout error,
    reverted the launch controller to sequence.
    - also updated the frame for the lidar in the xacro
    [sensors.urdf.xacro]
2025-02-06 fix: Don't include gazebo information if not in sim
    [perseus.ros2_control.xacro]
2025-02-06 fix: Real-world launch now works
    The joint state broadcaster needs to launch no matter what, with the base controller launching based on *it*
2025-02-06 fix: Include ERPM motor speed divisor
    [vesc_system.cpp]
2025-02-06 fix: Use correct axes for xbox deadman switch(es)
2025-02-10 Created raspberry pi camera server
2025-02-13 docs: Updated teleop page with current network details.
2025-02-15 hardware: Initial livox driver added to nix
2025-02-19 chore: Update launch file
    Now works with the current node semantics. Also added arguments for configuring the controller node
2025-02-21 perseus_sensors(livox): patched msg in livox-ros-driver2
    - the build still fails for lack of /dev from livox-sdk2 but
    the msg error is patched.
2025-02-22 perseus_sensors(livox): no progress, issue with INCLUDEs for driver
    - the LIVOX_INTERFACE_INCLUDE_DIRECTORIES is not set causing issues
2025-02-23 perseus_sensors(m2m2_lidar): Added param for reading the imu or not
2025-02-25 feat: Add empty BMS firmware
    [partitions.csv]
2025-02-27 Create motor gauge styling
2025-02-27 Finished styling for motor stats
2025-03-03 ci: Build on ARM runner
2025-03-08 Made progress on rcb driver
2025-03-08 fix: Add base type constructor for `SimpleSerializable`
    [hi_can_parameter.hpp]
2025-03-08 Added bus power management widget
2025-03-11 added 2 bytes of padding as vesc deseralise expects 8 bytes, but was only receiving 6.
2025-03-11 feat: Add realsense2-camera dependency
2025-03-15 autonomy: chassis base link o
2025-03-16 fix: Use correct signs and update reported data
    [hi_can_parameter.cpp, vesc_system.cpp]
2025-03-16 fix: Rotate m2m2 90deg CW
    [sensors.urdf.xacro]
2025-03-16 fix: Use m2m2 frame for gazebo lidar
    [sensors.urdf.xacro]
2025-03-16 fix: Convert wheel odom from E-revs to real revs
    [vesc_system.cpp]
2025-03-17 fix: Can interface node now on the real can bus
2025-03-17 Added names to the cameras
2025-03-18 fix: Camera name position styling
2025-03-20 Signalling server now prints to console
2025-03-22 fix: rcb driver now used nlohmann json
2025-03-22 Cameras now use device ID rather than videoX number
2025-03-22 Online Aysnc Finally Working!!!
    [perseus.urdf.xacro]
2025-03-22 Camera servers only action requests target at them
2025-03-22 feat: Initial board support package
2025-03-22 feat: Initial BMS implementation
2025-03-23 fix: added null checker for argument in camera socket communication
2025-03-23 Added scolling to cameras
2025-03-23 fix: Use correct path filters
2025-03-24 Added debug prints
2025-03-24 fix: `lifter_platform` -> `elevator_module`
    [hi_can_address.hpp, hi_can_parameter.hpp]
2025-03-24 feat: Implement elevator CAN control
    Switched to ESP-IDF from pure Arduino and linked hi-can
    [partitions.csv]
2025-03-24 ci: fix build filtering
2025-03-24 feat: untested light tower code
    [partitions.csv]
2025-03-24 Light tower code with the correct data pin and high density led count
    [main.cpp]
2025-03-24 Correct number of low density LED's
    [main.cpp]
2025-03-24 fix: Increase cmd_vel timeout
    Allows for clock desync across devices at the expense of some safety
    [perseus_controllers.yaml]
2025-03-25 cleaned up unused motor2 and stopmotor function()
2025-03-26 feat: Zero startup charge
2025-03-26 feat: Configure BMS more reliably
2025-03-26 fix: Shorten auto-shutdown time
    [main.cpp]
2025-03-27 feat: Short shutdown on unload
    [main.cpp]
2025-03-27 fix: Allow for filtering
2025-03-27 fix: Add message filtering
    [main.cpp]
2025-03-28 autonomy: launch files and mapping changes (at comp):
    [perseus.urdf.xacro, perseus_controllers.yaml, sensors.urdf.xacro]
2025-03-29 feat: Livox config + URDF
    [sensors.urdf.xacro]
2025-03-29 Added a yarn script to run camera with internet
2025-03-30 feat: Generic controller implementation
    [8bitdo_controller.yaml, xbox_controller_wired.yaml, xbox_controller_wireless.yaml]
2025-04-07 feat: Add DC motor driver project
    [dc-motor-driver.kicad_pcb, dc-motor-driver.kicad_sch]
2025-04-07 feat: Add Board Footprints library
2025-04-07 Feat initial PCB schematic
    [dc-motor-driver.kicad_sch]
2025-04-08 Footprints and BOM added
    [dc-motor-driver.kicad_sch, motor-driver.kicad_sch]
2025-04-11 initial pcb routing
    [dc-motor-driver.kicad_pcb, dc-motor-driver.kicad_sch, motor-driver.kicad_sch]
2025-04-11 Replaced large current traces for copper pours and tweaked placement of components
    [dc-motor-driver.kicad_pcb]
2025-04-12 arm_teleop_direct: Initial working code that controls one arm
2025-04-12 arm-teleop-direct: Added todo feature list to README.md
2025-04-12 arm-teleop-direct: moved main.cpp and fixed curses and boost conflict
    [main.cpp, perseus-arm-teleop.hpp]
2025-04-12 arm_teleop_direct: torque disables if mirroring is ended
2025-04-12 arm_teleop_direct: set global torque control and added visual load
2025-04-12 arm_teleop_direct: correct saved yaml name
    [main.cpp]
2025-04-12 arm_teleop_direct: default to torque protection to OFF
2025-04-12 arm_telop_direct: fixed overload reset
    [main.cpp]
2025-04-12 arm-teleop-network: initial code
2025-04-12 arm-teleop: Added the server implementation
2025-04-12 arm-teleop: added more debug info to Server
2025-04-12 arm-teleop: fixed debug log location
2025-04-12 arm-teleop: Added basic build instructions to README
2025-04-12 arm-teleop: improved access to include dirs
2025-04-12 arm-teleop: added yaml-cpp to flake.nix
2025-04-12 arm-teleop: fix the yellowing highlighting when mirrored
2025-04-12 arm-teleop: Fixed so follower displays values at all times
2025-04-12 arm-teleop: Updated readme
2025-04-12 arm-teleop: Added save and load calibration to the follower
2025-04-12 arm-teleop: fixed the min and max display values on follower
2025-04-12 arm-teleop: attempt to fix range on follower
2025-04-12 arm-teleop: fixed warning
2025-04-12 arm-teleop: correct for min/max range on follower
2025-04-12 arm-teleop: removed leader calibration display
2025-04-12 arm-teleop: fixed scale on follower settings
2025-04-12 arm-teleop: added more protection around servo position callback
2025-04-12 arm-teleop: added debug info to file
2025-04-12 arm-teleop: pre-enable the servos
2025-04-12 arm-teleop: attempt to stop lock out
2025-04-12 arm-teleop: added delay to promote serial stabiliy
2025-04-12 arm-teleop: added more delay for more stability
2025-04-12 arm-teleop: improved the yaml load to keep mirror state
2025-04-12 arm-teleop: attempt to make serial comms more robust
2025-04-12 arm-teleop: attempts to stablise serial comms
2025-04-12 arm-teleop: added corrections to network and not direct
    [perseus-arm-teleop.hpp]
2025-04-12 arm-teleop: added more robustness to serial comms
2025-04-12 arm-teleop: improve robust serial comms
2025-04-12 arm-teleop: fixing the scale position used
2025-04-12 arm-teleop: changed baud to 115200
2025-04-12 arm-teleop: trying 128000 baud
2025-04-12 arm-teleop: revertedto 115200 in follower-main
2025-04-12 arm-telop: more debug around ncurses init
2025-04-12 arm-teleop: more debug around init
2025-04-12 arm-teleop: added more debug around serial commencement
2025-04-12 arm-teleop: debug around network init
2025-04-12 arm-teleop: initial code for minimal implementation to test with
2025-04-12 arm-teleop: added the protocol-mini file
2025-04-12 arm-teleop: corrected default port in mini implementation
2025-04-12 arm-teleop: for follower-mini added debugging
2025-04-12 arm-teleop: fixed USB vs ACM
2025-04-12 arm-teleop: altered hardcoded ip address
2025-04-12 arm-teleop: leader-mini more robust on network retries
2025-04-12 arm-teleop: added more debugging to follower-main-mini
2025-04-12 arm-teleop: attmept to correct mini protocol
    -seems to blok follower-mini
2025-04-12 arm-teleop: updated readme with current issue
2025-04-12 arm-teleop: mini implementation
2025-04-12 arm-teleop: correct baud rate
2025-04-12 arm-teleop: correct baud in second spot
2025-04-12 arm-teleop-direct: attempt to fix bad changes from network
    [perseus-arm-teleop.cpp, perseus-arm-teleop.hpp]
2025-04-12 arm-teleop-driect: reverting to known working version
    [perseus-arm-teleop.cpp]
2025-04-12 arm-teleop-direct: fixed baud to 115200
    [main.cpp]
2025-04-12 arm-teleop: fixed typo in main
    [main.cpp]
2025-04-12 arm_teleop: corrected the use of magic numbers
    - with respect of the Servo Register values
    [main.cpp, perseus-arm-teleop.hpp, servo-constants.hpp]
2025-04-12 arm_control: fixed missing include and constants
    [main.cpp]
2025-04-12 arm_control: additional magic numbers corrected
    [main.cpp, perseus-arm-teleop.cpp]
2025-04-12 arm_control: aditional magic numbers corrected
    [main.cpp]
2025-04-12 fix: Add KiCAD gitignore
2025-04-12 feat: WIP PCB layout
    [dc-motor-driver.kicad_pcb, dc-motor-driver.kicad_sch, motor-driver.kicad_sch]
2025-04-13 Initial H-Bridge layout with SB footprint added
    [dc-motor-driver.kicad_pcb]
2025-04-13 feat: DRC rules, more layout done
    [dc-motor-driver.kicad_pcb, dc-motor-driver.kicad_sch]
2025-04-14 Rough routing of motor_in for H-bridges
    [dc-motor-driver.kicad_pcb, dc-motor-driver.kicad_sch]
2025-04-14 feat: Routing progress
    [dc-motor-driver.kicad_pcb, dc-motor-driver.kicad_sch]
2025-04-15 feat: Include export files in KiCAD ignore
2025-04-15 feat: Add more footprints+symbols
2025-04-15 feat: Add template schematic sheet
2025-04-15 feat: Layout done
    [dc-motor-driver.kicad_pcb, dc-motor-driver.kicad_sch, motor-driver.kicad_sch]
2025-04-16 fix: rcb power state inverted
2025-04-18 fix: widget manager now only inserts new widget if there is enough space
2025-04-19 arm_teleop: removed h-bridge schematic info
2025-04-22 added silkscreens to PCB and confirmed PCB ready for manufacturing
    [dc-motor-driver.kicad_pcb, dc-motor-driver.kicad_sch]
2025-04-22 feat: Add Grey silkscreen
    [dc-motor-driver.kicad_pcb]
2025-04-22 adjust BOM export settings
2025-04-25 fix: Use references wherever possible
    [main.cpp]
2025-05-04 feat: New bucket IDs + params
2025-05-12 feat: Implement new E&C code
    [partitions.csv]
2025-05-12 feat: Update driver for new E&C PCB
2025-05-12 Made documentation for assembling Perseus
2025-05-12 feat: Magnet control on D-pad
    Also split config into its own package to speed up testing rebuilds
    [8bitdo_controller.yaml, xbox_controller_wired.yaml, xbox_controller_wireless.yaml]
2025-05-13 fix: Correct voltage scaling
    [main.cpp]
2025-05-13 Added camera transofrm functionality
2025-05-19 feat: Increase slow turning authority
    [8bitdo_controller.yaml]
2025-06-28 Camera system overhaul MVP
2025-07-08 Updated power on steps and added note about zellij use
2025-07-08 Removed old camera code
2025-07-10 Updated Livox driver to run on /tmp
    - Creates a config with host IP in /tmp
    - Needs testing with livox
    - Runs driver on /tmp
2025-07-19 Imu 2D and 3D vis widgets
2025-08-29 p-l-split-description: add Perseus Lite robot description package
    - Add URDF/xacro files for Perseus Lite robot model
    - Include 3D mesh files for visualization
    - Add ROS 2 control interfaces for simulation
    - Include launch files for viewing robot in RViz
    - Add Nix package definition"
    [chassis.urdf.xacro, motor_wheel.urdf.xacro, perseus_lite.materials.xacro, perseus_lite.ros2_control.xacro, perseus_lite.urdf.xacro, rocker.urdf.xacro, sensors.urdf.xacro, wheel.urdf.xacro]
2025-08-29 p-l-hardware: add ST3215 hardware interface for Perseus Lite
    - Implement ROS 2 control hardware interface for ST3215 servos
    - Add serial communication protocol for motor control
    - Support position, velocity, and effort control modes
    - Include comprehensive documentation for ST3215 protocol
    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
2025-08-29 p-l-slpit-navigation: add navigation stack integration for Perseus Lite
    - Integrate Nav2 for autonomous navigation
    - Configure SLAM Toolbox for mapping and localization
    - Add Extended Kalman Filter for sensor fusion
    - Include tuned navigation parameters
    - Add RViz configuration for navigation visualization"
2025-08-29 p-l-split-i2c_imu: add I2C IMU driver for Perseus sensors
    - Implement I2C communication for IMU devices
    - Support multiple IMU models (MPU6050, MPU9250, BNO055)
    - Add ROS 2 hardware interface for IMU data
    - Include configuration and launch files
    - Add comprehensive documentation
    - Update xbox controller launch file
    - Update M2M2 lidar implementation"
    [i2c_imu.urdf.xacro]
2025-09-03 perseus-lite(description): Changes to macros
    - removed some large mesh files by using macros
    - updated the dependency from p-l to perseus-description in the process
    [chassis.urdf.xacro, motor_wheel.urdf.xacro, rocker.urdf.xacro]
2025-09-03 docs(gazebo): added workaround for bugged ros2 control daemon
    - current instructions appear to hit a bug where the ros2 control
    daemon is not accessible
    - added workaround to docs
2025-09-12 Added config file and logitech config type to launch file
    [logitech_controller.yaml]
2025-11-04 p-l:hardware: corrected MAX RPM scale factor
    [st3215_system.cpp, st3215_system.hpp]
2025-11-04 p-l:hardware: correct Jazzy temperature implementation
    [st3215_system.cpp]
2025-11-04 p-l:hardware: fix pi implementation
    [st3215_system.hpp]
2025-11-04 p-l:hardware: used correct logging level
    [st3215_system.cpp]
2025-11-04 p-l:hardware: corrected variable names that had been missed in recent corrections
    [st3215_system.cpp, st3215_system.hpp]
2025-11-06 chore: remove i2c_imu_driver planning document
2025-11-06 (p-l): add Perseus Lite main package
    Add Perseus Lite ROS2 package with controllers and hardware integration:
    creates perseus_lite ROS2 package structure (package.xml, CMakeLists.txt)
    adds ROS2 control configuration for differential drive
    implements launch files for robot bringup, controllers, and robot state publisher
    sets up joint state broadcaster and diff drive controller
    adds URDF integration with perseus_lite_description and ros2_control
    includes Nix package definition (perseus-lite.nix)
    updates Nix overlay to include perseus-lite package
    Cleans up perseus-can-if.nix dependencies
    Part of the perseus-lite-split PR series.
    Needs the following to be merged beforehand:
    PR #253 (perseus_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
    [perseus_lite.urdf.xacro, perseus_lite_controllers.yaml]
2025-11-08 feat: created bucket widget component
2025-11-17 p-l docs: added an example of joint state
2025-11-20 p-l: corrected basic implementation of i2c to RAII
    [i2c_device.cpp, i2c_device.hpp, i2c_imu_node.cpp, imu_device_config.cpp, imu_device_config.hpp]
2025-11-20 p-l-i2c: clean up
2025-11-20 p-l-i2c: removed unused variables
2025-11-20 p-l-i2c:corrected issues with wrong bytes being read for imu data
    [imu_device_config.cpp]
2025-11-22 p-l-i2c_imu: all CamelCase function names changed to use ssssnake_case
2025-11-22 Add models and world configuration for Perseus Australian Rover Challenge (Autonomy Map) simulation
    - Created ArUco markers models (aruco_markers4 and aruco_markers5) with associated SDF and config files.
    - Added textures for ArUco markers.
    - Introduced cubes model with multiple colored cubes and their configurations.
    - Established main world model for the Perseus Arc Challenge, including walls and obstacles.
    - Configured RViz view settings for simulation visualization.
    - Included necessary plugins and physics settings in the world file.
    [model.sdf]
2025-11-22 Added a timer running every 100ms checking the joy topic
2025-11-22 Refactor URDF and XACRO files for Perseus robot
    - Updated `perseus.materials.xacro` to include proper XML namespace.
    - Enhanced `perseus.urdf.xacro` with additional properties for robot dimensions, motors, and sensors. Improved joint definitions for better clarity and structure.
    - Modified `rocker.urdf.xacro` to fix negative values and streamline the definition of rocker properties.
    - Updated `sensors.urdf.xacro` to define 3D and 2D LIDAR sensors with appropriate Gazebo configurations.
    - Refined `wheel.urdf.xacro` to define individual wheel links with proper inertial properties and Gazebo settings for friction.
    - Adjusted `CMakeLists.txt` to ensure proper installation of directories related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
    [camera_depth.urdf.xacro, chassis.urdf.xacro, flange_bearing.urdf.xacro, inertia_macros.xacro, motor_wheel.urdf.xacro, perseus.materials.xacro, perseus.urdf.xacro, rocker.urdf.xacro]
2025-11-23 Update ARUCO marker textures and remove unused files
    [model.sdf]
2025-11-23 p-l-i2c-imu: removed the SO-100 planning document that was an error
2025-11-26 Fixed rcb driver node
2025-11-27 handle SWITCH_FAILED aswell
2025-11-27 Fix(controller_timeout): Added launch parameter for timeout and set timeout length as parameter in yaml config files
    [8bitdo_controller.yaml, logitech_controller.yaml, xbox_controller_wired.yaml, xbox_controller_wireless.yaml]
2025-11-27 chore: Format and lint
    [8bitdo_controller.yaml]
2025-11-27 Feat(nix-bucket): Created bucket launch file
2025-11-27 Finished bucket driver widget
    [logitech_controller.yaml]
2025-11-27 Feat(nix-bucket): Added payload parameter to perseus launch file and created function to launch a payload
2025-11-27 Feat(nix-bucket): Docs of payload flag
2025-11-27 Refactor URDF files to improve properties and dimensions for various components, including camera, chassis, flange bearing, rocker, and wheels. Update sensor configurations in gz_bridge.yaml for bett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
    [camera_depth.urdf.xacro, chassis.urdf.xacro, flange_bearing.urdf.xacro, inertia_macros.xacro, motor_wheel.urdf.xacro, perseus.urdf.xacro, rocker.urdf.xacro, sensors.urdf.xacro]
2025-11-27 Refactor URDF files to standardize mesh scale formatting and improve collision definitions for various components including camera, chassis, flange bearing, motor wheel, rocker, and wheel.
    [camera_depth.urdf.xacro, chassis.urdf.xacro, flange_bearing.urdf.xacro, motor_wheel.urdf.xacro, perseus.urdf.xacro, rocker.urdf.xacro, wheel.urdf.xacro]
2025-11-27 Refactor URDF and XACRO files for motor, rocker, and wheel components to improve structure and add dynamic properties for better simulation accuracy.
    [motor_wheel.urdf.xacro, perseus.urdf.xacro, rocker.urdf.xacro, wheel.urdf.xacro]
2025-11-27 Remove unnecessary properties for motor mass and collision dimensions in motor_wheel.urdf.xacro
    [motor_wheel.urdf.xacro]
2025-11-27 Refactor URDF and XACRO files to remove unnecessary properties for camera, flange bearing, motor wheel, and sensors, improving overall structure and clarity.
    [camera_depth.urdf.xacro, flange_bearing.urdf.xacro, motor_wheel.urdf.xacro, perseus.urdf.xacro, sensors.urdf.xacro, wheel.urdf.xacro]
2025-11-27 Refactor chassis properties in URDF files to standardize mass definitions and improve clarity.
    [chassis.urdf.xacro, perseus.urdf.xacro]
2025-11-30 Fix wheel and motor orientation for left and right sides in URDF files to ensure correct simulation behavior.
    [motor_wheel.urdf.xacro, wheel.urdf.xacro]
2025-11-30 Reorder base_link and base_footprint definitions for improved structure and clarity in URDF file
    [perseus.urdf.xacro]
2025-11-30 undo base_footprint changes
    [perseus.urdf.xacro]
2025-11-30 Remove flake.nix change to allow OMEN44 approval
    The rplidar-ros package is already a dependency of perseus-sensors,
    so it will be built automatically. The flake.nix addition was only
    for dev shell convenience and blocked the PR from being approved
    since OMEN44 is not a code owner for *.nix files.
2025-11-30 Made URDF REP-103/REP-105 aligned,ready for Nav2 integration
    - wheel.urdf.xacro - Unified wheel axis to -Y for REP-103 compliance (positive velocity = forward)
    - inertia_macros.xacro - Added cylinder_inertia_y macro for Y-axis aligned cylinders
    - wheel.urdf.xacro - using cylinder inertia, and friction tuned [mu=1.5, mu2=0.2]
    - xbox_controller.py - Negated joystick axes for ROS convention, removed conditional rotation inversion
    - All controller YAMLs - Negative scaling for forward/turn to match ROS convention
    [8bitdo_controller.yaml, inertia_macros.xacro, logitech_controller.yaml, wheel.urdf.xacro, xbox_controller_wired.yaml, xbox_controller_wireless.yaml]
2025-12-01 Add teleop_diagnostics TUI for teleoperation debugging
    New ROS2 package with comprehensive TUI diagnostic tool showing:
    - Raw joystick input (axes, buttons, rates)
    - Generic controller configuration (scaling, axis mappings, enables)
    - Velocity command chain (joy_vel -> twist_mux -> cmd_vel_out)
    - Wheel joint states (positions, velocities, directions)
    - Twist mux priority and active source visualization
    - Wheel axis configuration (REP-103 compliance info)
    - Real-time direction indicator with speed info
    Usage: ros2 run teleop_diagnostics teleop_tui
    Requires 'rich' Python library for full TUI (pip install rich),
    falls back to simple text mode if not available.
2025-12-01 Add frame ID to IMU sensor for correct frame association
    [chassis.urdf.xacro]
2025-12-03 corrected URDF, generic and xbox controller and the telop diag TUI
    [8bitdo_controller.yaml, logitech_controller.yaml, wheel.urdf.xacro, xbox_controller_wired.yaml, xbox_controller_wireless.yaml]
2025-12-03 merged updates from feat/extracted-tftree-sim-world
    [wheel.urdf.xacro, xbox_controller_wireless.yaml]
2025-12-03 Resolve merge conflict in xbox_controller_wireless.yaml
    Keep positive scaling approach (0.7) which has been tested end-to-end.
    [xbox_controller_wireless.yaml]
2025-12-03 fix: Remove merge conflict markers and clarify axis comment in wheel URDF
    [wheel.urdf.xacro]
2025-12-04 fix: Pin firmware toolchain for build reliability
    - Pinned platform to specific version instead of latest stable to ensure all toolchains are the same
    - Integrated the board support as a local PIO library
    - Switch to managing Arduino core through the framework instead of as an ESP-IDF component
2025-12-04 docs: Change standard to `snake_case`
    - Previously `camelCase`
    - Matches ROS de-facto standard
2025-12-04 build: Add `-Wshadow` to standard flags
    Prevents using variable/type/class/etc names in local scopes which override outer scopes.
    [hi_can_address.hpp, hi_can_parameter.hpp]
2025-12-04 docs: Add Arduino naming note
    Carve out exception to naming for Arduino-based code
2025-12-05 feat: Update controller parameters and add EKF configuration for simulation
    [perseus_controllers.yaml]
2025-12-05 feat: Adjust update rate and enable odometry transforms in controller configuration
    [perseus_controllers.yaml]
2025-12-05 feat: Disable odometry transforms and remove wheel odometry configuration for EKF integration
    [perseus_controllers.yaml]
2025-12-06 feat: Add initial documentation for Perseus's URDF
2025-12-06 feat: Remove outdated Robot Description documentation and add comprehensive URDF details
2025-12-06 feat: Add initial Robot Description to extended Kalman filter documentation
2025-12-22 Fixed payload launch flag issue and removed canbus argument for bucket launch file
2025-12-23 docs: Updated network docs to include current Unifi configuration
2025-12-24 docs: Added images and links to our current networking gear
2026-01-04 Added option for saving camera feed to file, fixed undefined camera bug
2026-01-12 Feat: Update URDF and configuration for camera and lidar integration to meet with current topics name, position and orientation.
    [camera_depth.urdf.xacro, perseus.urdf.xacro, sensors.urdf.xacro]
2026-01-15 Feat: Add Nix-managed CUDA support with GPU passthrough
    - Add CUDA toolkit packages (nvcc, cudart, cublas, etc.) to dev shell
    - Add nixcuda wrapper for running CUDA binaries with host GPU driver
    - Add CUDA environment variables (CUDA_PATH, CUDA_HOME) to shell hook
    - Add cuda-test script to verify CUDA environment status
    - Use nix-gl-host for GPU driver passthrough (works on x86_64 and Jetson)
    The CUDA toolkit is Nix-managed for portability, while GPU access uses
    host driver passthrough via nixcuda wrapper. Gracefully handles systems
    without a GPU.
2026-01-17 Fix: Add Jetson CUDA library paths to nixcuda wrapper
    On Jetson devices, the CUDA driver and runtime libraries are located
    at host system paths that need to be in LD_LIBRARY_PATH for CUDA
    programs to run. This adds those paths (/usr/lib/aarch64-linux-gnu/tegra
    and /usr/local/cuda/lib64) to the nixcuda wrapper.
2026-01-17 fix: Added current user to trusted-users in nix-setup.sh script
2026-01-17 refactor(teleop_diagnostics): replace magic numbers with named constants and add runtime discovery
    - Add SCREAMING_SNAKE_CASE constants for timing, thresholds, and UI dimensions
    - Discover mux priorities from /twist_mux at startup
    - Discover controller config from /generic_controller at startup
    - Load wheel dimensions via ROS parameters
    - Fall back to sensible defaults when nodes unavailable
2026-01-20 feat: Refactor waypoint error handling and improve timer management for SSR compatibility by changing window to globalThis
2026-01-20 feat: Update default image topic for ROSStreamViewer widget to '/camera/camera/color/image_raw'
2026-01-20 feat: Change topic type from 'string' to 'text' in ROSStreamViewer widget and refactor timer management in StartStopAutonomy widget for SSR compatibility
2026-01-21 feat/pointcloud conversion to laserscan for nav2 & slam
2026-01-21 feat: Add behavior tree for navigation with replanning and recovery
    - Introduced a new behavior tree XML file for navigating to a pose with replanning and recovery actions.
    - Configured recovery nodes for path computation and following, including costmap clearing actions.
    chore: Add navigation simulation parameters
    - Created a new YAML configuration file for navigation simulation parameters.
    - Adjusted parameters for AMCL, BT navigator, local and global costmaps, and various plugins for improved performance.
    fix: Update SLAM Toolbox parameters
    - Modified SLAM Toolbox parameters for better mapping and localization performance.
    - Adjusted parameters related to scan matching, loop closure,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
    [nav_sim_params.yaml]
2026-01-21 feat: Fix EKF parameters and add keepout filter launch file
    [ekf_params.yaml, nav_sim_params.yaml]
2026-01-21 feat: Update base_link to match with center of kinematics
    [perseus.urdf.xacro]
2026-01-21 feat: Update RViz configuration for improved visualization and adjust frame settings
2026-01-23 feat: Update EKF parameters for 2D mode and IMU configuration; enhance navigation simulation parameters and RViz visualization settings
2026-01-24 feat: Update package descriptions and licenses; add IMU topic launch argument
2026-01-24 feat: Remove keepout filter launch file
2026-01-24 feat: Adjust laser and camera joint positions in URDF file
    [perseus.urdf.xacro]
2026-01-25 fix/added config file + coding standards
    [laserscan_to_pointcloud_node.hpp, pointcloud_to_laserscan_node.hpp]
2026-01-25 Enhance RViz configuration and URDF models
    - Updated RViz configuration to include new TF panel and additional frames (base_footprint, camera_link, camera_link_optical, livox_frame) with appropriate visibility settings.
    - Adjusted marker scale and view parameters for improved visualization.
    - Modified camera_depth.urdf.xacro to use a mesh for the camera representation instead of a box.
    - Corrected the position of the livox_frame in perseus.urdf.xacro for better alignment.
    - Updated sensors.urdf.xacro to include a mesh for the Livox MID-360 and adjusted its visual and collision origins.
    - Simplified the gazebo launch process by removing unnecessary nix commands
    [camera_depth.urdf.xacro, perseus.urdf.xacro, sensors.urdf.xacro]
2026-01-25 feat: Update joint origin and rotation for laser and lidar sensors
    [perseus.urdf.xacro, sensors.urdf.xacro]
2026-01-25 feat: Update camera joint rotation in URDF file
    [perseus.urdf.xacro]
2026-01-25 docs: CAN bus initial documentation
2026-01-25 docs: Add CAN filtering and address allocation
    Added:
    - Description of how filters are used
    - Address bit allocation
    - General formatting and syntax updates
2026-01-25 fix: Update navigation parameters for improved performance and robustness
    [nav_sim_params.yaml]
2026-01-25 fix: Update EKF and navigation parameters for improved sensor integration
    [ekf_config.yaml, nav_sim_params.yaml]
2026-01-25 fix: Clean up Doxygen warnings
    [hi_can_address.hpp]
2026-01-25 docs: Add physical hardware section
    Includes usage for the CAN daisy chain PCB.
2026-01-25 docs: Overhaul CAN bus documentation
2026-01-28 feat: enhance ArUco detector with camera info integration and parameter adjustments
2026-01-28 feat: update aruco_detector configuration for input image and camera info
2026-02-01 fix: Fixed warnings shown when running colcon build
    [mcb_system.cpp, mcb_system.hpp, st3215_system.cpp, st3215_system.hpp, vesc_system.cpp, vesc_system.hpp]
2026-02-02 feat: update camera frame and distortion coefficients in aruco_detector configuration; adjust coordinate transformation in image processing
2026-02-03 feat: add min_bounding_box_area parameter and filtering logic for ArucoDetector
2026-02-03 fix: correct camera frame reference and adjust pose coordinates in ArUco marker processing
    [perseus_vision.yaml]
2026-02-17 feat: Add dual-stick Xbox controller support
    Add opt-in dual-stick driving mode where left stick controls
    forward/backward and right stick controls turning. Bucket controls
    are remapped to buttons in this mode. Activated via dual_stick:=true
    launch argument.
    [xbox_controller_wired_dual_stick.yaml, xbox_controller_wireless_dual_stick.yaml]
2026-02-17 docs: Add dual-stick driving mode to teleop guide
    Document the dual_stick launch argument, usage examples, and
    button remapping tables for wireless and wired Xbox controllers.
2026-02-17 fix: Correct wireless dual-stick turn axis to axis 3
    [xbox_controller_wireless_dual_stick.yaml]
2026-02-26 fix: address review issues in aruco detector
    - Fix cv::solveOnP typo to cv::solvePnP (compilation blocker)
    - Fix executable name mismatch between CMake and launch file
    - Fix compressed mode silently ignoring use_camera_info
    - Fix unsynchronized latest_ids_ access in service handler
    - Replace custom quaternion conversion with tf2::Matrix3x3
    - Add camera_matrix parameter size validation
    - Rename booleans to use verb prefixes per coding standard
    - Replace magic number QoS depth with named constant
    - Remove redundant frame clone in image capture
    - Add timestamp to capture filenames to prevent overwrites
    - Add Doxygen comments to class and constructor
    - Update docs to reflect solvePnP usage
2026-02-26 fix: restore cv::solvePnP fix reverted by format commit
    The upstream format-and-lint commit re-introduced the cv::solveOnP
    typo. cv::solveOnP does not exist in OpenCV — the correct function
    is cv::solvePnP.
2026-02-28 Add IMU Bias Estimator and Remover components with launch files
    - Implemented BiasEstimator and BiasRemover as composable nodes for IMU bias correction.
    - Created launch files: bias_remover.launch.py, lidar_processing.launch.py, pcl_to_lsc.launch.py, rs_launch.py, topic_remapper_launch.py.
    - Added topic remapper node to dynamically remap topics with configurable parameters.
    - Integrated RealSense camera launch with image compression capabilities.
    - Enhanced bias estimator with stationary detection logic and rate control.
    - Implemented topic remapper to publish messages at a reduced frequency.
    [main.cpp]
2026-03-01 Updated Launch
    - Adds an interface selection to work with two subnets on the jetson
    - eth1 is the interface the livox will be on usually
    - eth0 is the rest of the network
2026-03-07 Fix: added camera resolution and jpeg stream support
2026-03-07 added frame patch from /camera_init -> /base_link
2026-03-07 mid360 configuration working based on dan's livox driver
2026-03-10 change name of pointcloud_to_laserscan package to pcl_to_lsr to avoid conflicting with ROS package already existed in the nix ros overlay
    [laserscan_to_pointcloud_node.hpp, pointcloud_to_laserscan_node.hpp, visibility_control.h]
2026-03-11 feat: Add Open3D 0.19.0 to Nix-managed environment
    Build Open3D from source with Python 3.13 support (no pre-built wheels
    exist for 3.13). Uses system deps where compatible (eigen, fmt, embree,
    pybind11, VTK, etc.) and pre-fetches bundled deps (TBB, assimp,
    tinyobjloader, tinygltf, MKL, IPP, UVAtlas) for Nix sandbox
    compatibility.
    Build configuration: GUI disabled, CUDA disabled, ISPC disabled.
    C++ library builds and links successfully. Python module assembly
    still in progress.
2026-03-12 fix: Make Open3D conditional on x86_64 to fix ARM CI builds
    Open3D depends on Intel MKL/IPP binaries which are x86_64 only.
    Use lib.optionalAttrs/optionalString to skip open3d in standardPkgs,
    the PYTHONPATH shell hook, and the Python deps env on non-x86_64.
2026-03-12 refactor: Address PR review — use inherit idiom, move demo to utilities
2026-03-13 feat: Add RealSense URDF and update related configurations
    [camera_depth.urdf.xacro, perseus.urdf.xacro]
2026-03-13 feat: Add camera_d455_gazebo URDF and remove deprecated camera_depth URDF
    [camera_d455_gazebo.xacro, camera_depth.urdf.xacro, perseus.urdf.xacro]
2026-03-13 refactor: Remove unused livox launch file inclusion from lidar_processing.launch.py
2026-03-14 feat: Update camera_d455_gazebo URDF to use 'name' parameter and adjust sensor references
    [camera_d455_gazebo.xacro, perseus.urdf.xacro]
2026-03-14 patch fix for odometry
2026-03-14 feat: Update camera topics and frames in URDF and configuration files
    [camera_d455_gazebo.xacro, perseus.urdf.xacro, sensors.urdf.xacro]
2026-03-15 Update cmd_vel topic remappings in twist_mux.launch.py and correct output topic in nav_sim_params.yaml
    [nav_sim_params.yaml]
2026-03-15 feat: Added and patched lidarslam-ros2
2026-03-16 fix: update cmd_vel_out_topic for collision_monitor to cmd_vel_nav_stamped
    [perseus_nav_params.yaml]
2026-03-16 fix: update cmd_vel_out_topic in collision_monitor for clarity
    [nav_sim_params.yaml, perseus_nav_params.yaml]
2026-03-16 feat: Add FAST-LIO odometry integration with EKF sensor fusion
    - Add ekf_config_fast_lio.yaml with dual odometry (wheel + FAST-LIO) and IMU fusion at 30Hz
    - Add odom1 FAST-LIO /Odometry source to ekf_params.yaml with relative pose settings
    - Lower ekf_config.yaml frequency from 50Hz to 20Hz
    - Default autonomy launch to FAST-LIO EKF config and corrected IMU topic
    - Enable Nav2 composition mode by default
    [ekf_config.yaml, ekf_config_fast_lio.yaml]
2026-03-16 fix: Address PR review feedback
    - Revert ekf_params.yaml (used by Perseus Lite, which doesn't run FAST-LIO)
    - Revert use_composition default change (inert; autonomy.launch.py hardcodes "False")
    - Fix copy-paste comment: "wheel odometry (odom0)" -> "FAST-LIO LiDAR-inertial odometry (odom1)"
    - Set imu0 topic to /livox/imu/corrected in YAML to match launch default
    [ekf_config_fast_lio.yaml, ekf_params.yaml]
2026-03-17 docs(templates): Removed broken 'nix-package.sh’ reference
2026-03-17 fix: adjust controller parameters for improved navigation stability
    [nav_sim_params.yaml]
2026-03-18 feat: Update camera topic parameter for cube_detector configuration
2026-03-18 feat: Enhance cube_detector with depth estimation capabilities and improved topic configurations
    [camera_depth.urdf.xacro]
2026-03-19 fix: update controller parameters for improved navigation performance
    [nav_sim_params.yaml]
2026-03-19 feat: add target frame parameter handling in pose transformation
2026-03-19 feat: add sensor_msgs dependency and implement 2D detection publishing
2026-03-20 feat: update package name for Pointcloud to LaserScan converter
2026-03-22 fix(sensor): update gz_frame_id to reference camera_link instead of camera_link_optical
    [camera_depth.urdf.xacro]
2026-03-26 feat: Update camera topics to use dynamic naming convention
    [camera_d455_gazebo.xacro]
2026-03-26 feat: Update RealSense URDF and configuration for improved topic naming and sensor types
    [camera_d455_gazebo.xacro]
2026-03-26 feat: rsbl driver in testing
2026-03-26 feat: added ros drivers
2026-03-26 Fix: errors from hi_can refactor
    [hi_can_parameter.hpp, rmd_driver.cpp, rsbl_driver.cpp]
2026-03-26 Feat: Motor drivers work except control topic
2026-03-26 Fix: /arm/status not publishing
2026-03-26 Feat: RSBL multi turn encoder software
    [partitions.csv]
2026-03-26 Feat: added arm driver project
    [partitions.csv]
2026-03-26 Feat: split driver code into two microcontrollers
2026-03-26 Fix: Correct motor ids
    [hi_can_address.hpp, main.cpp]
2026-03-26 Fix: Send angles to drivers works
    [rmd_driver.cpp, rsbl_driver.cpp]
2026-03-26 Feat: added arduino to the project and implemented pwm control code
    [partitions.csv]
2026-03-26 Feat: correctly implemented parameter group
    [end_effector.cpp, hi_can_address.hpp, hi_can_parameter.cpp, hi_can_parameter.hpp]
2026-03-26 fix: correct bit masks for pwm parameter group
    [end_effector.cpp, hi_can_parameter.cpp]
2026-03-26 Feat: end effector PWM control working
2026-03-26 feat: Added 5th pwm and space resources code
2026-03-26 feat: added pwm 5 address
2026-03-26 Feat: added pwm 5 to high level software
2026-03-26 Fix: remove incorrect initial position code
    [main.cpp]
2026-03-26 Fix: missing dependencies and merge errors
    [main.cpp]
2026-03-26 Feat: added script to create links for duplicate camera ids
2026-03-28 Fix: update RealSense configuration to disable color and depth streams
    [realsense_launch.yaml]
2026-03-28 Fix: update depth and infrared profiles in RealSense configuration
    [realsense_launch.yaml]
